mahdi-rstgr/formulation-sdl-atlas/wiki-src/docs/references.md

# References

All 178 references of the review *Self-Driving Laboratories for Formulation: Handling Liquids, Pastes, Powders and Objects, from Robots to Digital Twins and AI Agents* (manuscript V3, in preparation, 2026), numbered as in the manuscript. Citations of the form [n] throughout this wiki link here.

!!! info "Other sources"

    A few pages reconstructed from the earlier version of this wiki also list textbooks, standards and vendor documentation under *Further reading*. Those entries are not part of the review's reference list.

<div class="ref-list" markdown>

<span id="ref-1"></span>**\[1\]** Abolhasani, M.; Kumacheva, E. The rise of self-driving labs in chemical and materials sciences. Nat. Synth. 2023, 2, 483–492. <https://doi.org/10.1038/s44160-022-00231-0>

<span id="ref-2"></span>**\[2\]** Rastegardoost, M. M.; Tafreshi, O. A.; Saadatnia, Z.; Ghaffari-Mosanenzadeh, S.; Park, C. B.; Naguib, H. E. Recent advances on porous materials and structures for high-performance triboelectric nanogenerators. Nano Energy 2023, 111, 108365. <https://doi.org/10.1016/j.nanoen.2023.108365>

<span id="ref-3"></span>**\[3\]** Burger, B.; Maffettone, P. M.; Gusev, V. V.; Aitchison, C. M.; Bai, Y.; Wang, X.; Li, X.; Alston, B. M.; Li, B.; Clowes, R.; Rankin, N.; Harris, B.; Sprick, R. S.; Cooper, A. I. A mobile robotic chemist. Nature 2020, 583, 237–241. <https://doi.org/10.1038/s41586-020-2442-2>

<span id="ref-4"></span>**\[4\]** Szymanski, N. J.; Rendy, B.; Fei, Y.; Kumar, R. E.; He, T.; Milsted, D.; McDermott, M. J.; Gallant, M.; Cubuk, E. D.; Merchant, A.; Kim, H.; Jain, A.; Bartel, C. J.; Persson, K.; Zeng, Y.; Ceder, G. An autonomous laboratory for the accelerated synthesis of inorganic materials. Nature 2023, 624, 86–91. <https://doi.org/10.1038/s41586-023-06734-w>

<span id="ref-5"></span>**\[5\]** King, R. D.; Rowland, J.; Oliver, S. G.; Young, M.; Aubrey, W.; Byrne, E.; Liakata, M.; Markham, M.; Pir, P.; Soldatova, L. N.; Sparkes, A.; Whelan, K. E.; Clare, A. The automation of science. Science 2009, 324 (5923), 85–89. <https://doi.org/10.1126/science.1165620>

<span id="ref-6"></span>**\[6\]** Steiner, S.; Wolf, J.; Glatzel, S.; Andreou, A.; Granda, J. M.; Keenan, G.; Hinkley, T.; Aragon-Camarasa, G.; Kitson, P. J.; Angelone, D.; Cronin, L. Organic synthesis in a modular robotic system driven by a chemical programming language. Science 2019, 363 (6423), eaav2211. <https://doi.org/10.1126/science.aav2211>

<span id="ref-7"></span>**\[7\]** MacLeod, B. P.; Parlane, F. G. L.; Morrissey, T. D.; Häse, F.; Roch, L. M.; Dettelbach, K. E.; Moreira, R.; Yunker, L. P. E.; Rooney, M. B.; Deeth, J. R.; Lai, V.; Ng, G. J.; Situ, H.; Zhang, R. H.; Elliott, M. S.; Haley, T. H.; Dvorak, D. J.; Aspuru-Guzik, A.; Hein, J. E.; Berlinguette, C. P. Self-driving laboratory for accelerated discovery of thin-film materials. Sci. Adv. 2020, 6 (20), eaaz8867. <https://doi.org/10.1126/sciadv.aaz8867>

<span id="ref-8"></span>**\[8\]** Seifrid, M.; Pollice, R.; Aguilar-Granda, A.; Morgan Chan, Z.; Hotta, K.; Ser, C. T.; Vestfrid, J.; Wu, T. C.; Aspuru-Guzik, A. Autonomous chemical experiments: challenges and perspectives on establishing a self-driving lab. Acc. Chem. Res. 2022, 55 (17), 2454–2466. <https://doi.org/10.1021/acs.accounts.2c00220>

<span id="ref-9"></span>**\[9\]** Stach, E.; DeCost, B.; Kusne, A. G.; Hattrick-Simpers, J.; Brown, K. A.; Reyes, K. G.; Schrier, J.; Billinge, S.; Buonassisi, T.; Foster, I.; Gomes, C. P.; Gregoire, J. M.; Mehta, A.; Montoya, J.; Olivetti, E.; Park, C.; Rotenberg, E.; Saikin, S. K.; Smullin, S.; Stanev, V.; Maruyama, B. Autonomous experimentation systems for materials development: a community perspective. Matter 2021, 4 (9), 2702–2726. <https://doi.org/10.1016/j.matt.2021.06.036>

<span id="ref-10"></span>**\[10\]** Tom, G.; Schmid, S. P.; Baird, S. G.; Cao, Y.; Darvish, K.; Hao, H.; Lo, S.; Pablo-García, S.; Rajaonson, E. M.; Skreta, M.; Yoshikawa, N.; Corapi, S.; Akkoc, G. D.; Strieth-Kalthoff, F.; Seifrid, M.; Aspuru-Guzik, A. Self-driving laboratories for chemistry and materials science. Chem. Rev. 2024, 124 (16), 9633–9732. <https://doi.org/10.1021/acs.chemrev.4c00055>

<span id="ref-11"></span>**\[11\]** Velasco, P. Q.; Low, K. Y. A.; Leong, C. J.; Ng, W. T.; Qiu, S.; Jhunjhunwala, S.; Li, B.; Qian, A.; Hippalgaonkar, K.; Cheng, J. J. W. Optimization of liquid handling parameters for viscous liquid transfers with pipetting robots, a "sticky situation." Digital Discovery 2024, 3 (5), 1011–1020. <https://doi.org/10.1039/D3DD00255A>

<span id="ref-12"></span>**\[12\]** Radulov, N.; Little, T.; Cooper, A. I.; Pizzuto, G. Vision-guided adaptive scooping for powder weighing in autonomous chemistry laboratories. Digital Discovery 2026, 5 (5), 2120–2127. <https://doi.org/10.1039/D5DD00569H>

<span id="ref-13"></span>**\[13\]** Tadros, T. F. Rheology of Dispersions: Principles and Applications; Wiley-VCH: Weinheim, 2010. ISBN 978-3-527-32003-5.

<span id="ref-14"></span>**\[14\]** Mezger, T. G. The Rheology Handbook: For Users of Rotational and Oscillatory Rheometers, 5th ed.; Vincentz Network: Hannover, 2020. ISBN 978-3-86630-532-8.

<span id="ref-15"></span>**\[15\]** Opentrons Labworks Inc. OT-2 and Flex Liquid Handling Robots; product pages. <https://opentrons.com/products/ot-2-robot> (accessed 2026).

<span id="ref-16"></span>**\[16\]** Hamilton Company. Microlab STAR Automated Liquid Handling Workstation; product page. <https://www.hamiltoncompany.com> (accessed 2026).

<span id="ref-17"></span>**\[17\]** Nordson EFD. Ultimus V Precision Dispenser; product page. <https://www.nordson.com/en/products/efd-products/ultimus-v-dispensers> (accessed 2026).

<span id="ref-18"></span>**\[18\]** Bahr, M. N.; Damon, D.; Yates, S.; Chin, A.; Christopher, D.; Cromer, S.; Perrotto, N.; Quiroz, J.; Rosso, V. Collaborative Evaluation of Commercially Available Automated Powder Dispensing Platforms for High-Throughput Experimentation in Pharmaceutical Applications. Org. Process Res. Dev. 2018, 22 (11), 1500–1508. <https://doi.org/10.1021/acs.oprd.8b00259>

<span id="ref-19"></span>**\[19\]** Barnes, H. A. A Handbook of Elementary Rheology; University of Wales Institute of Non-Newtonian Fluid Mechanics: Aberystwyth, 2000 (reprinted 2005). ISBN 0-9538032-0-1.

<span id="ref-20"></span>**\[20\]** Macosko, C. W. Rheology: Principles, Measurements, and Applications; VCH Publishers: New York, 1994. ISBN 1-56081-579-5.

<span id="ref-21"></span>**\[21\]** Kanase, D.; Watson, T. Viscous Liquid Handling Automation Using the Opentrons OT-2; Application Note; Opentrons Labworks Inc. <https://opentrons-landing-img.s3.amazonaws.com/application+notes/Viscous+Liquids+App+Note.pdf> (accessed 2026).

<span id="ref-22"></span>**\[22\]** Deshmukh, S.; Bishop, M. T.; Dermody, D.; Dietsche, L.; Kuo, T.-C.; Mushrush, M.; Harris, K.; Zieman, J.; Morabito, P.; Orvosh, B.; Patrick, D. A Novel High-Throughput Viscometer. ACS Comb. Sci. 2016, 18 (7), 405–414. <https://doi.org/10.1021/acscombsci.5b00176>

<span id="ref-23"></span>**\[23\]** Soh, B. W.; Chitre, A.; Tan, S. Z.; Wang, Y.; Yi, Y.; Soh, W.; Hippalgaonkar, K.; Wilson, D. I. Opentrons for automated and high-throughput viscometry. Digital Discovery 2025, 4 (3), 711–722. <https://doi.org/10.1039/D4DD00368C>

<span id="ref-24"></span>**\[24\]** Zhang, H.; Jin, J.; Zhao, Z.; He, Z.; Zhou, Y.; Duan, X. Self-focused acoustically driven pL-level dispensing pipet enabling rapid concentration gradient generation. Anal. Chem. 2025, 97 (47), 26274–26282. <https://doi.org/10.1021/acs.analchem.5c05838>

<span id="ref-25"></span>**\[25\]** Durrer, J.; Agrawal, P.; Ozgul, A.; Neuhauss, S. C. F.; Nama, N.; Ahmed, D. A robot-assisted acoustofluidic end effector. Nat. Commun. 2022, 13, 6370. <https://doi.org/10.1038/s41467-022-34167-y>

<span id="ref-26"></span>**\[26\]** Ozgulbas, D. Y. et al. Robotic pendant drop: containerless liquid for μs-resolved, AI-executable XPCS. Light Sci. Appl. 2023, 12, 196. <https://doi.org/10.1038/s41377-023-01233-z>

<span id="ref-27"></span>**\[27\]** Xu, S.; Nunez, C. M.; Souri, M.; Wood, R. J. A compact DEA-based soft peristaltic pump for power and control of fluidic robots. Sci. Robot. 2023, 8 (79), eadd4649. <https://doi.org/10.1126/scirobotics.add4649>

<span id="ref-28"></span>**\[28\]** Walker, M.; Pizzuto, G.; Fakhruldeen, H.; Cooper, A. I. Go with the flow: deep learning methods for autonomous viscosity estimations. Digital Discovery 2023, 2 (5), 1540–1547. <https://doi.org/10.1039/D3DD00109A>

<span id="ref-29"></span>**\[29\]** Rastegardoost, M. M.; Tafreshi, O. A.; Saadatnia, Z.; Ghaffari-Mosanenzadeh, S.; Park, C. B.; Naguib, H. E. Porous PVDF mats with significantly enhanced dielectric properties and novel dipole arrangement for high-performance triboelectric nanogenerators. Appl. Mater. Today 2023, 30, 101732. <https://doi.org/10.1016/j.apmt.2023.101732>

<span id="ref-30"></span>**\[30\]** Malkin, A. Ya.; Derkach, S. R.; Kulichikhin, V. G. Rheology of Gels and Yielding Liquids. Gels 2023, 9 (9), 715. <https://doi.org/10.3390/gels9090715>

<span id="ref-31"></span>**\[31\]** Luo, X.; Jin, S.; Huang, H.-J.; Yuan, W. An Intelligent Robotic System for Perceptive Pancake Batter Stirring and Precise Pouring. In 2024 IEEE/RSJ International Conference on Intelligent Robots and Systems (IROS); IEEE, 2024. arXiv:2407.01755.

<span id="ref-32"></span>**\[32\]** Yang, X.; Ji, Z.; Lai, Y.-K. Differentiable physics-based system identification for robotic manipulation of elastoplastic materials. Int. J. Robot. Res. 2025, 44 (13), 2126–2155. <https://doi.org/10.1177/02783649251334661>

<span id="ref-33"></span>**\[33\]** Kelly, D.; Sergis, V.; Ventura i Blanco, L.; Mason, K.; Daly, A. C. Autonomous control of extrusion bioprinting using convolutional neural networks. Adv. Funct. Mater. 2025, 35, 2424553. <https://doi.org/10.1002/adfm.202424553>

<span id="ref-34"></span>**\[34\]** Shin, J.; Kang, R.; Hyun, K.; Li, Z.; Kumar, H.; Kim, K.; Park, S. S.; Kim, K. Machine learning-enhanced optimization for high-throughput precision in cellular droplet bioprinting. Adv. Sci. 2025, 12 (20), e2412831. <https://doi.org/10.1002/advs.202412831>

<span id="ref-35"></span>**\[35\]** Rastegardoost, M. M.; Tafreshi, O. A.; Saadatnia, Z.; Ghaffari-Mosanenzadeh, S.; Serles, P.; Filleter, T.; Park, C. B.; Naguib, H. E. Highly durable triboelectric nanogenerators based on fibrous fluoropolymer composite mats with enhanced mechanical and dielectric properties. Mater. Today Energy 2023, 38, 101431. <https://doi.org/10.1016/j.mtener.2023.101431>

<span id="ref-36"></span>**\[36\]** Abbas, F.; Salehian, M.; Hou, P. et al. Accelerated drug development using a digital formulator and a self-driving tableting data factory. Nat. Commun. 2026, 17, 4739. <https://doi.org/10.1038/s41467-026-71204-6>

<span id="ref-37"></span>**\[37\]** Fermier, A. M.; Troisi, J.; Heritage, E. C.; Drexel, M. A.; Gallea, P.; Swinney, K. A. Powder dispensing robot for sample preparation. Analyst 2003, 128, 790–795. <https://doi.org/10.1039/b300274h>

<span id="ref-38"></span>**\[38\]** Kadokawa, Y.; Hamaya, M.; Tanaka, K. Learning robotic powder weighing from simulation for laboratory automation. In 2023 IEEE/RSJ International Conference on Intelligent Robots and Systems (IROS); IEEE: Detroit, MI, 2023; pp. 2932–2939.

<span id="ref-39"></span>**\[39\]** Radulov, N.; Wright, A.; Little, T.; Cooper, A. I.; Pizzuto, G. FLIP: Flowability-Informed Powder Weighing. arXiv:2506.03896, 2025.

<span id="ref-40"></span>**\[40\]** Takahashi, T.; Nakajima, Y.; Beltran-Hernandez, C. C.; Kuroda, Y.; Tanaka, K.; Hamaya, M.; Ono, K.; Ushiku, Y. A Flexible Funnel-Shaped Robotic Hand with an Integrated Single-Sheet Valve for Milligram-Scale Powder Handling. arXiv:2512.07091, 2025.

<span id="ref-41"></span>**\[41\]** Wei, M.; Yang, X.; Lai, Y.-K.; Tafrishi, S. A.; Ji, Z. A physics-informed demonstration-guided learning framework for granular material manipulation. IEEE Trans. Neural Netw. Learn. Syst. 2026, 37 (4), 1590–1604. <https://doi.org/10.1109/TNNLS.2025.3622482>

<span id="ref-42"></span>**\[42\]** Szymańska, E.; Hughes, J. Robotic optimization of powdered beverages leveraging computer vision and Bayesian optimization. Front. Robot. AI 2025, 12, 1603729. <https://doi.org/10.3389/frobt.2025.1603729>

<span id="ref-43"></span>**\[43\]** Xu, J.; Jia, Y.; Yang, D.; Meng, P.; Zhu, X.; Guo, Z.; Song, S.; Ciocarlie, M. Tactile-based object retrieval from granular media. Auton. Robots 2025, 49 (4), 32. <https://doi.org/10.1007/s10514-025-10212-9>

<span id="ref-44"></span>**\[44\]** Treers, L.; Soto, D.; Hwang, J.; Goodisman, M. A. D.; Goldman, D. I. Robot excavation and manipulation of geometrically cohesive granular media. Granular Matter 2026, 28 (2), 35. <https://doi.org/10.1007/s10035-025-01597-6>

<span id="ref-45"></span>**\[45\]** Lo, S.; Baird, S. G.; Schrier, J.; Blaiszik, B.; Carson, N.; Foster, I.; Aguilar-Granda, A.; Kalinin, S. V.; Maruyama, B.; Politi, M.; Tran, H.; Sparks, T. D.; Aspuru-Guzik, A. Review of low-cost self-driving laboratories in chemistry and materials science: the “frugal twin” concept. Digital Discovery 2024, 3 (5), 842–868. <https://doi.org/10.1039/D3DD00223C>

<span id="ref-46"></span>**\[46\]** SainSmart. Genmitsu 4040-PRO Desktop CNC Machine; product page, <https://www.sainsmart.com/collections/cnc-machines/products/genmitsu-4040-pro-semi-assembly-desktop-cnc-machine-for-carving-and-cutting>; running accuracy from the 4040-PRO MAX product page, <https://www.sainsmart.com/products/4040-pro-max> (accessed 2026).

<span id="ref-47"></span>**\[47\]** igus GmbH. drylin XYZ Gantry Robot; product configurator page. <https://www.igus.com/automation/xyz-gantry> (accessed 2026).

<span id="ref-48"></span>**\[48\]** Machine Agency, University of Washington. Jubilee: An Open-Source Multi-Tool Motion Platform; specifications, <https://jubilee3d.com/index.php?title=Specs>; and Science Jubilee Pipette Tool documentation, <https://science-jubilee.readthedocs.io/en/latest/building/pipette_tool.html> (accessed 2026).

<span id="ref-49"></span>**\[49\]** Brooks Automation (Precise Automation). PreciseFlex 400; datasheet 379272-en-US. <https://www.brooks.com> (accessed 2026).

<span id="ref-50"></span>**\[50\]** Seiko Epson Corporation. RS3 SCARA Robot (RRS-351SSR13); product page. <https://www.epson.com> (accessed 2026).

<span id="ref-51"></span>**\[51\]** Universal Robots A/S. UR3e Collaborative Robot Arm; product page and e-Series datasheet. <https://www.universal-robots.com/products/ur3e/> (accessed 2026).

<span id="ref-52"></span>**\[52\]** UFACTORY. xArm 6 Collaborative Robot; product page. <https://www.ufactory.us/product/ufactory-xarm-6> (accessed 2026).

<span id="ref-53"></span>**\[53\]** UFACTORY. Lite 6 Collaborative Robot Arm; product listing (Knox Labs). <https://www.knoxlabs.com/products/ufactory-lite-6-collaborative-robot-arm> (accessed 2026).

<span id="ref-54"></span>**\[54\]** Franka Robotics GmbH. Franka Research 3; datasheet R02212, Rev. 2.4. <https://franka.de/hubfs/Datasheet_FrankaResearch3_R02212_2.4.pdf?hsLang=en> (accessed 2026).

<span id="ref-55"></span>**\[55\]** Kinova Inc. Gen3 Ultra Lightweight Robot; one-pager specification. <https://www.kinovarobotics.com/uploads/Kinova_Onepager_Gen3_2024_EN.pdf> (accessed 2026).

<span id="ref-56"></span>**\[56\]** Lunt, A. M.; Fakhruldeen, H.; Pizzuto, G. et al. Modular, multi-robot integration of laboratories: an autonomous workflow for solid-state chemistry. Chem. Sci. 2024, 15 (7), 2456–2463. <https://doi.org/10.1039/D3SC06206F>

<span id="ref-57"></span>**\[57\]** Dai, T.; Vijayakrishnan, S.; Szczypiński, F. T.; Ayme, J.-F.; Simaei, E.; Fellowes, T.; Clowes, R.; Kotopanov, L.; Shields, C. E.; Zhou, Z.; Ward, J. W.; Cooper, A. I. Autonomous mobile robots for exploratory synthetic chemistry. Nature 2024, 635, 890–897. <https://doi.org/10.1038/s41586-024-08173-7>

<span id="ref-58"></span>**\[58\]** KUKA AG. KMR iiwa Mobile Robot System; product brochure, <https://www.parmley-graham.co.uk/content/wp-content/uploads/2024/07/KUKA_KMRiiwa_EN.pdf>; platform positioning, <https://qviro.com/product/kuka/kmr-iiwa>; reseller price listing, <https://www.indiamart.com/proddetail/kuka-kmr-iiwa-2854399368830.html> (accessed 2026).

<span id="ref-59"></span>**\[59\]** Rainin (Mettler-Toledo). E4 XLS+ Electronic Pipette; product specification. <https://www.shoprainin.com/Products/Pipettes-and-Tips/Pipettes/Single-Channel-Electronic-Pipettes/E4-XLS/E4-Electronic-Pipette,-LTS-E4-1000XLS+/p/17014482> (accessed 2026).

<span id="ref-60"></span>**\[60\]** Eppendorf SE. Xplorer / Xplorer plus Electronic Pipettes; product page. <https://www.eppendorf.com/us-en/Products/Liquid-Handling/All-Pipettes-Dispensers-Automated-Liquid-Handlers/Eppendorf-Xplorer-Eppendorf-Xplorer-plus-p-PF-191054> (accessed 2026).

<span id="ref-61"></span>**\[61\]** Gilson, Inc. MICROMAN E Positive-Displacement Pipette; User’s Guide LT801547-E. <https://es.gilson.com/pub/media/docs/LT801547-E_MICROMAN_E_UG_web.pdf> (accessed 2026).

<span id="ref-62"></span>**\[62\]** Hamilton Company. PSD/4 Syringe Pump; specification sheet. <https://www.hamiltoncompany.com/knowledge-base/spec-sheet/psd-4-specification-sheet> (accessed 2026).

<span id="ref-63"></span>**\[63\]** Watson-Marlow Fluid Technology Solutions. Qdos 20 Chemical Metering Pump; product page. <https://www.wmfts.com/en-us/brands/watson-marlow-peristaltic-pumps/cased-pumps/qdos-accurate-versatile-chemical-dosing-pumps/> (accessed 2026).

<span id="ref-64"></span>**\[64\]** Cole-Parmer (Avantor). Masterflex L/S Digital Precision Pump System; product listing. <https://www.fishersci.com/shop/products/masterflex-l-s-digital-precision-pump-systems-open-head-sensor-easy-load-head-4/11747346> (accessed 2026).

<span id="ref-65"></span>**\[65\]** CELLINK (BICO Group). Syringe Pump Printhead; product page. <https://www.cellink.com/product/syringe-pump-printhead/> (accessed 2026).

<span id="ref-66"></span>**\[66\]** Allevi (3D Systems). Allevi 2 Bioprinter; product page. <https://www.allevi3d.com/allevi-2/> (accessed 2026).

<span id="ref-67"></span>**\[67\]** CELLINK (BICO Group). BIO X Pneumatic Printhead; product page. <https://www.cellink.com/product/bio-x-pneumatic-printhead/> (accessed 2026).

<span id="ref-68"></span>**\[68\]** ViscoTec Pumpen- u. Dosiertechnik GmbH. preeflow eco-PEN Precision Volumetric Dosing Pump; product page. <https://www.preeflow.com/en/hoechste-praezision-als-standard/> (accessed 2026).

<span id="ref-69"></span>**\[69\]** Fisnar Inc. PDV-1000 Precision Positive-Displacement Auger Valve; product page. <https://www.fisnar.com/products/dispensing-valves/positive-displacement-dispensing-valves/pdv1000-precision-positive-displacement-auger-valves/> (accessed 2026).

<span id="ref-70"></span>**\[70\]** Coperion K-Tron. Micro-Screw Feeders (MT12); product page. <https://coperion.com/en/products-services/process-equipment/feeders/micro-screw-feeders> (accessed 2026).

<span id="ref-71"></span>**\[71\]** Chemspeed Technologies AG. SWILE Gravimetric Powder Dosing; product page. <https://www.chemspeed.com/crystal-swile/> (accessed 2026).

<span id="ref-72"></span>**\[72\]** Mettler-Toledo International. Quantos Automated Powder and Liquid Dosing; data sheet. <https://www.mt.com/us/en/home/library/product-brochures/laboratory-weighing/06_Automated_Sample_Preparation/02_QB_Liquid_Powder_Dispensing/02_Data_Sheets/DS_QB_Powde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> (accessed 2026).

<span id="ref-73"></span>**\[73\]** 3P Innovation Ltd. VF1 Vibratory Feeder; product page. <https://www.3pinnovation.com/pharma-equipment/discover-range/vibratory-feeder> (accessed 2026).

<span id="ref-74"></span>**\[74\]** Eriez Manufacturing Co. Hi-Vi Volumatic Feeder Machine; product page. <https://www.eriez.com/Products/Sample-Preparation/Vibratory-Feeders/Volumatic-Feeder-Machine> (accessed 2026).

<span id="ref-75"></span>**\[75\]** Eppendorf SE. epMotion 5075 Automated Pipetting Workstation; technical specifications brochure. <https://www.eppendorf.com> (accessed 2026).

<span id="ref-76"></span>**\[76\]** Dispendix GmbH. I.DOT Non-Contact Liquid Handler; product page. <https://www.dispendix.com/idot-non-contact-liquid-handler> (accessed 2026).

<span id="ref-77"></span>**\[77\]** Tecan Group Ltd. Fluent Laboratory Automation Workstation; product page. <https://lifesciences.tecan.com/fluent-laboratory-automation-workstation> (accessed 2026).

<span id="ref-78"></span>**\[78\]** Beckman Coulter Life Sciences. Biomek i7 Automated Workstation; product page. <https://www.beckman.com/liquid-handlers/biomek-i-series-automated-workstations/biomek-i7> (accessed 2026).

<span id="ref-79"></span>**\[79\]** Agilent Technologies. Bravo Automated Liquid Handling Platform; product page. <https://www.agilent.com/en/product/automated-liquid-handling/automated-liquid-handling-platforms/bravo-automated-liquid-handling-platform> (accessed 2026).

<span id="ref-80"></span>**\[80\]** Beckman Coulter Life Sciences. Echo 525 Acoustic Liquid Handler; product page. <https://www.beckman.com/liquid-handlers/echo-acoustic/echo-525> (accessed 2026).

<span id="ref-81"></span>**\[81\]** Soh, B. W.; Chitre, A.; Lee, W. Y.; Bash, D.; Kumar, J. N.; Hippalgaonkar, K. Automated pipetting robot for proxy high-throughput viscometry of Newtonian fluids. Digital Discovery 2023, 2 (2), 481–488. <https://doi.org/10.1039/D2DD00126H>

<span id="ref-82"></span>**\[82\]** Councill, E. E. A. W.; Axtell, N. B.; Truong, T.; Liang, Y.; Aposhian, A. L.; Webber, K. G. I.; Zhu, Y.; Cong, Y.; Carson, R. H.; Kelly, R. T. Adapting a low-cost and open-source commercial pipetting robot for nanoliter liquid handling. SLAS Technol. 2021, 26 (3), 310–319. <https://doi.org/10.1177/2472630320973591>

<span id="ref-83"></span>**\[83\]** Axtell, N. B.; Webber, K. G. I. et al. Modification of a low-cost pipetting robot for nanoliter liquid handling and autosampling for liquid chromatography-mass spectrometry. J. Sep. Sci. 2026, 49 (2), e70379. <https://doi.org/10.1002/jssc.70379>

<span id="ref-84"></span>**\[84\]** Yoshikawa, N.; Darvish, K.; Ghazi Vakili, M.; Garg, A.; Aspuru-Guzik, A. Digital pipette: open hardware for liquid transfer in self-driving laboratories. Digital Discovery 2023, 2 (6), 1745–1751. <https://doi.org/10.1039/D3DD00115F>

<span id="ref-85"></span>**\[85\]** Zwirnmann, H.; Knobbe, D.; Culha, U.; Haddadin, S. Towards flexible biolaboratory automation: container taxonomy-based, 3D-printed gripper fingers. In 2023 IEEE/RSJ International Conference on Intelligent Robots and Systems (IROS); IEEE: Detroit, MI, 2023. arXiv:2302.03644.

<span id="ref-86"></span>**\[86\]** Nazeri, M.; Watchorn, J.; Mei, S.; Zhang, A.; Allen, C.; Gu, F. Leveraging flexible pipette-based tool changes to transform liquid handling systems into dual-function sample preparation and imaging platforms. HardwareX 2025, 22, e00653. <https://doi.org/10.1016/j.ohx.2025.e00653>

<span id="ref-87"></span>**\[87\]** del Olmo Lianes, I.; Yubero, P.; Gómez-Luengo, Á.; Nogales, J.; Espeso, D. R. Technical upgrade of an open-source liquid handler to support bacterial colony screening. Front. Bioeng. Biotechnol. 2023, 11, 1202836. <https://doi.org/10.3389/fbioe.2023.1202836>

<span id="ref-88"></span>**\[88\]** Wierenga, R. P.; Golas, S. M.; Ho, W.; Coley, C. W.; Esvelt, K. M. PyLabRobot: an open-source, hardware-agnostic interface for liquid-handling robots and accessories. Device 2023, 1 (4), 100111. <https://doi.org/10.1016/j.device.2023.100111>

<span id="ref-89"></span>**\[89\]** Grieves, M.; Vickers, J. Digital twin: mitigating unpredictable, undesirable emergent behavior in complex systems. In Transdisciplinary Perspectives on Complex Systems; Kahlen, F.-J., Flumerfelt, S., Alves, A., Eds.; Springer: Cham, 2017; pp 85–113. <https://doi.org/10.1007/978-3-319-38756-7_4>

<span id="ref-90"></span>**\[90\]** Tao, F.; Zhang, H.; Liu, A.; Nee, A. Y. C. Digital twin in industry: state-of-the-art. IEEE Trans. Ind. Inform. 2019, 15 (4), 2405–2415. <https://doi.org/10.1109/TII.2018.2873186>

<span id="ref-91"></span>**\[91\]** Pal, P. K.; Hens, A.; Behera, N.; Lahiri, S. K. Digital twins: transforming the chemical process industry—a review. Can. J. Chem. Eng. 2025, 103 (8), 3611–3636. <https://doi.org/10.1002/cjce.25611>

<span id="ref-92"></span>**\[92\]** Zhang, S.; Zhang, J.; Lapkin, A. A. A knowledge graph framework for digital twins of chemical processes. Nat. Chem. Eng. 2026, 3 (5), 286–297. <https://doi.org/10.1038/s44286-026-00392-1>

<span id="ref-93"></span>**\[93\]** Rihm, S. D.; Bai, J.; Kondinski, A.; Mosbach, S.; Akroyd, J.; Kraft, M. Transforming research laboratories with connected digital twins. Nexus 2024, 1 (1), 100004. <https://doi.org/10.1016/j.ynexs.2024.100004>

<span id="ref-94"></span>**\[94\]** SimPy. SimPy: discrete event simulation for Python; software documentation. <https://simpy.readthedocs.io> (accessed 2026).

<span id="ref-95"></span>**\[95\]** Bär, H.; Hochstrasser, R.; Papenfuß, B. SiLA: basic standards for rapid integration in laboratory automation. J. Lab. Autom. 2012, 17 (2), 86–95. <https://doi.org/10.1177/2211068211424550>

<span id="ref-96"></span>**\[96\]** Macenski, S.; Foote, T.; Gerkey, B.; Lalancette, C.; Woodall, W. Robot Operating System 2: design, architecture, and uses in the wild. Sci. Robot. 2022, 7 (66), eabm6074. <https://doi.org/10.1126/scirobotics.abm6074>

<span id="ref-97"></span>**\[97\]** Coleman, D.; Şucan, I. A.; Chitta, S.; Correll, N. Reducing the barrier to entry of complex robotic software: a MoveIt! case study. J. Softw. Eng. Robot. 2014, 5 (1), 3–16. arXiv:1404.3785.

<span id="ref-98"></span>**\[98\]** Beeson, P.; Ames, B. TRAC-IK: an open-source library for improved solving of generic inverse kinematics. In 2015 IEEE-RAS 15th International Conference on Humanoid Robots (Humanoids); IEEE: Seoul, South Korea, 2015; pp 928–935. <https://doi.org/10.1109/HUMANOIDS.2015.7363472>

<span id="ref-99"></span>**\[99\]** Şucan, I. A.; Moll, M.; Kavraki, L. E. The Open Motion Planning Library. IEEE Robot. Autom. Mag. 2012, 19 (4), 72–82. <https://doi.org/10.1109/MRA.2012.2205651>

<span id="ref-100"></span>**\[100\]** Pan, J.; Chitta, S.; Manocha, D. FCL: a general purpose library for collision and proximity queries. In 2012 IEEE International Conference on Robotics and Automation (ICRA); IEEE: Saint Paul, MN, USA, 2012; pp 3859–3866. <https://doi.org/10.1109/ICRA.2012.6225337>

<span id="ref-101"></span>**\[101\]** Fakhruldeen, H.; Pizzuto, G.; Glowacki, J.; Cooper, A. I. ARChemist: autonomous robotic chemistry system architecture. In 2022 International Conference on Robotics and Automation (ICRA); IEEE: Philadelphia, PA, USA, 2022; pp 6013–6019. <https://doi.org/10.1109/ICRA46639.2022.9811996>

<span id="ref-102"></span>**\[102\]** Koenig, N.; Howard, A. Design and use paradigms for Gazebo, an open-source multi-robot simulator. In 2004 IEEE/RSJ International Conference on Intelligent Robots and Systems (IROS); IEEE: Sendai, Japan, 2004; Vol. 3, pp 2149–2154. <https://doi.org/10.1109/IROS.2004.1389727>

<span id="ref-103"></span>**\[103\]** Todorov, E.; Erez, T.; Tassa, Y. MuJoCo: a physics engine for model-based control. In 2012 IEEE/RSJ International Conference on Intelligent Robots and Systems (IROS); IEEE: Vilamoura-Algarve, Portugal, 2012; pp 5026–5033. <https://doi.org/10.1109/IROS.2012.6386109>

<span id="ref-104"></span>**\[104\]** Coumans, E.; Bai, Y. PyBullet, a Python module for physics simulation for games, robotics and machine learning; software, 2016–2021. <https://pybullet.org> (accessed 2026).

<span id="ref-105"></span>**\[105\]** Rohmer, E.; Singh, S. P. N.; Freese, M. V-REP: a versatile and scalable robot simulation framework. In 2013 IEEE/RSJ International Conference on Intelligent Robots and Systems (IROS); IEEE: Tokyo, Japan, 2013; pp 1321–1326. <https://doi.org/10.1109/IROS.2013.6696520>

<span id="ref-106"></span>**\[106\]** Michel, O. Cyberbotics Ltd. Webots™: professional mobile robot simulation. Int. J. Adv. Robot. Syst. 2004, 1 (1), 5. <https://doi.org/10.5772/5618>

<span id="ref-107"></span>**\[107\]** Makoviychuk, V.; Wawrzyniak, L.; Guo, Y. et al. Isaac Gym: high performance GPU-based physics simulation for robot learning. In Proceedings of the Neural Information Processing Systems Track on Datasets and Benchmarks 1 (NeurIPS Datasets and Benchmarks 2021); 2021; arXiv:2108.10470.

<span id="ref-108"></span>**\[108\]** Mittal, M.; Yu, C.; Yu, Q. et al. Orbit: a unified simulation framework for interactive robot learning environments. IEEE Robot. Autom. Lett. 2023, 8 (6), 3740–3747. <https://doi.org/10.1109/LRA.2023.3270034>

<span id="ref-109"></span>**\[109\]** Mittal, M.; Roth, P.; Tigue, J. et al. Isaac Lab: a GPU-accelerated simulation framework for multi-modal robot learning. arXiv 2025, arXiv:2511.04831.

<span id="ref-110"></span>**\[110\]** Li, S.; Huang, Y.; Guo, C.; Wu, T.; Zhang, J.; Zhang, L.; Ding, W. Chemistry3D: robotic interaction toolkit for chemistry experiments. In 2025 IEEE International Conference on Robotics and Automation (ICRA); IEEE: Atlanta, GA, USA, 2025; pp 8064–8071. <https://doi.org/10.1109/ICRA55743.2025.11128846>

<span id="ref-111"></span>**\[111\]** Darvish, K.; Sohal, A.; Mandal, A. et al. MATTERIX: toward a digital twin for robotics-assisted chemistry laboratory automation. Nat. Comput. Sci. 2026, 6 (1), 67–82. <https://doi.org/10.1038/s43588-025-00924-4>

<span id="ref-112"></span>**\[112\]** Hirt, C. W.; Nichols, B. D. Volume of fluid (VOF) method for the dynamics of free boundaries. J. Comput. Phys. 1981, 39 (1), 201–225. <https://doi.org/10.1016/0021-9991(81)90145-5>

<span id="ref-113"></span>**\[113\]** Monaghan, J. J. Smoothed particle hydrodynamics. Annu. Rev. Astron. Astrophys. 1992, 30, 543–574. <https://doi.org/10.1146/annurev.aa.30.090192.002551>

<span id="ref-114"></span>**\[114\]** Macklin, M.; Müller, M.; Chentanez, N.; Kim, T.-Y. Unified particle physics for real-time applications. ACM Trans. Graph. 2014, 33 (4). <https://doi.org/10.1145/2601097.2601152>

<span id="ref-115"></span>**\[115\]** Schenck, C.; Fox, D. SPNets: differentiable fluid dynamics for deep neural networks. In Proceedings of The 2nd Conference on Robot Learning (CoRL 2018), PMLR vol. 87; 2018; pp 317–335.

<span id="ref-116"></span>**\[116\]** Sulsky, D.; Chen, Z.; Schreyer, H. L. A particle method for history-dependent materials. Comput. Methods Appl. Mech. Eng. 1994, 118 (1–2), 179–196. <https://doi.org/10.1016/0045-7825(94)90112-0>

<span id="ref-117"></span>**\[117\]** Stomakhin, A.; Schroeder, C.; Chai, L.; Teran, J.; Selle, A. A material point method for snow simulation. ACM Trans. Graph. 2013, 32 (4), 102. <https://doi.org/10.1145/2461912.2461948>

<span id="ref-118"></span>**\[118\]** Huang, Z.; Hu, Y.; Du, T.; Zhou, S.; Su, H.; Tenenbaum, J. B.; Gan, C. PlasticineLab: a soft-body manipulation benchmark with differentiable physics. In International Conference on Learning Representations (ICLR 2021); 2021; arXiv:2104.03311.

<span id="ref-119"></span>**\[119\]** Hu, Y.; Anderson, L.; Li, T.-M.; Sun, Q.; Carr, N.; Ragan-Kelley, J.; Durand, F. DiffTaichi: differentiable programming for physical simulation. In International Conference on Learning Representations (ICLR 2020); 2020; arXiv:1910.00935.

<span id="ref-120"></span>**\[120\]** Xian, Z.; Zhu, B.; Xu, Z.; Tung, H.-Y.; Torralba, A.; Fragkiadaki, K.; Gan, C. FluidLab: a differentiable environment for benchmarking complex fluid manipulation. In International Conference on Learning Representations (ICLR 2023); 2023; arXiv:2303.02346.

<span id="ref-121"></span>**\[121\]** Cundall, P. A.; Strack, O. D. L. A discrete numerical model for granular assemblies. Géotechnique 1979, 29 (1), 47–65. <https://doi.org/10.1680/geot.1979.29.1.47>

<span id="ref-122"></span>**\[122\]** Coetzee, C. J. Review: calibration of the discrete element method. Powder Technol. 2017, 310, 104–142. <https://doi.org/10.1016/j.powtec.2017.01.015>

<span id="ref-123"></span>**\[123\]** Jop, P.; Forterre, Y.; Pouliquen, O. A constitutive law for dense granular flows. Nature 2006, 441 (7094), 727–730. <https://doi.org/10.1038/nature04801>

<span id="ref-124"></span>**\[124\]** Tobin, J.; Fong, R.; Ray, A.; Schneider, J.; Zaremba, W.; Abbeel, P. Domain randomization for transferring deep neural networks from simulation to the real world. In 2017 IEEE/RSJ International Conference on Intelligent Robots and Systems (IROS); IEEE: Vancouver, BC, Canada, 2017; pp 23–30. <https://doi.org/10.1109/IROS.2017.8202133>

<span id="ref-125"></span>**\[125\]** Boiko, D. A.; MacKnight, R.; Kline, B.; Gomes, G. Autonomous chemical research with large language models. Nature 2023, 624, 570–578. <https://doi.org/10.1038/s41586-023-06792-0>

<span id="ref-126"></span>**\[126\]** Yoshikawa, N.; Skreta, M.; Darvish, K. et al. Large language models for chemistry robotics. Auton. Robots 2023, 47 (8), 1057–1086. <https://doi.org/10.1007/s10514-023-10136-2>

<span id="ref-127"></span>**\[127\]** M. Bran, A.; Cox, S.; Schilter, O.; Baldassari, C.; White, A. D.; Schwaller, P. Augmenting large language models with chemistry tools. Nat. Mach. Intell. 2024, 6 (5), 525–535. <https://doi.org/10.1038/s42256-024-00832-8>

<span id="ref-128"></span>**\[128\]** Zhao, W.; Queralta, J. P.; Westerlund, T. Sim-to-real transfer in deep reinforcement learning for robotics: a survey. In 2020 IEEE Symposium Series on Computational Intelligence (SSCI); IEEE: Canberra, ACT, Australia, 2020; pp 737–744. <https://doi.org/10.1109/SSCI47803.2020.9308468>

<span id="ref-129"></span>**\[129\]** Mandal, I.; Soni, J.; Zaki, M. et al. Evaluating large language model agents for automation of atomic force microscopy. Nat. Commun. 2025, 16, 9104. <https://doi.org/10.1038/s41467-025-64105-7>

<span id="ref-130"></span>**\[130\]** Tang, X.; Jin, Q.; Zhu, K. et al. Risks of AI scientists: prioritizing safeguarding over autonomy. Nat. Commun. 2025, 16, 8317. <https://doi.org/10.1038/s41467-025-63913-1>

<span id="ref-131"></span>**\[131\]** Rastegardoost, M. M.; Tafreshi, O. A.; Ghaffari-Mosanenzadeh, S.; Park, C. B.; Naguib, H. E. Ultra-lightweight aerogel-fibrous material with high thermal stability and boosted triboelectricity for crack detection in harsh environments. Mater. Today Energy 2026, 56, 102221. <https://doi.org/10.1016/j.mtener.2026.102221>

<span id="ref-132"></span>**\[132\]** Rastegardoost, M. M.; Aghababaei Tafreshi, O.; Ghaffari-Mosanenzadeh, S.; Saadatnia, Z.; Park, C. B.; Naguib, H. E. Ultra-lightweight aerogel composites for sound-driven triboelectric nanogenerator. Nano Energy 2025, 136, 110765. <https://doi.org/10.1016/j.nanoen.2025.110765>

<span id="ref-133"></span>**\[133\]** Wilkinson, M. D.; Dumontier, M.; Aalbersberg, I. J. et al. The FAIR Guiding Principles for scientific data management and stewardship. Sci. Data 2016, 3, 160018. <https://doi.org/10.1038/sdata.2016.18>

<span id="ref-134"></span>**\[134\]** Lookman, T.; Balachandran, P. V.; Xue, D.; Yuan, R. Active learning in materials science with emphasis on adaptive sampling using uncertainties for targeted design. npj Comput. Mater. 2019, 5, 21. <https://doi.org/10.1038/s41524-019-0153-8>

<span id="ref-135"></span>**\[135\]** Shahriari, B.; Swersky, K.; Wang, Z.; Adams, R. P.; de Freitas, N. Taking the human out of the loop: a review of Bayesian optimization. Proc. IEEE 2016, 104 (1), 148–175. <https://doi.org/10.1109/JPROC.2015.2494218>

<span id="ref-136"></span>**\[136\]** Balandat, M.; Karrer, B.; Jiang, D. R.; Daulton, S.; Letham, B.; Wilson, A. G.; Bakshy, E. BoTorch: a framework for efficient Monte-Carlo Bayesian optimization. In Advances in Neural Information Processing Systems 33 (NeurIPS 2020); arXiv:1910.06403.

<span id="ref-137"></span>**\[137\]** Cao, L.; Russo, D.; Felton, K.; Salley, D.; Sharma, A.; Keenan, G.; Mauer, W.; Gao, H.; Cronin, L.; Lapkin, A. A. Optimization of formulations using robotic experiments driven by machine learning DoE. Cell Rep. Phys. Sci. 2021, 2 (1), 100295. <https://doi.org/10.1016/j.xcrp.2020.100295>

<span id="ref-138"></span>**\[138\]** OpenAI. GPT-4 Technical Report. arXiv:2303.08774, 2023.

<span id="ref-139"></span>**\[139\]** Anthropic. The Claude 3 Model Family: Opus, Sonnet, Haiku; model card, 2024. <https://www.anthropic.com/news/claude-3-family> (accessed 2026).

<span id="ref-140"></span>**\[140\]** Zhou, J.; Luo, M.; Chen, L.; Zhu, Q.; Jiang, S.; Zhang, F.; Shang, W.; Jiang, J. A multi-robot–multi-task scheduling system for autonomous chemistry laboratories. Digital Discovery 2025, 4 (3), 636–652. <https://doi.org/10.1039/D4DD00313F>

<span id="ref-141"></span>**\[141\]** Panapitiya, G.; Saldanha, E.; Job, H.; Hess, O. AutoLabs: cognitive multi-agent systems with self-correction for autonomous chemical experimentation. Sci. Rep. 2026, 16 (1), 19554. <https://doi.org/10.1038/s41598-026-45593-z>

<span id="ref-142"></span>**\[142\]** Rupprecht, S.; Gao, Q.; Karia, T.; Schweidtmann, A. M. Multi-agent systems for chemical engineering: a review and perspective. Curr. Opin. Chem. Eng. 2026, 51, 101209. <https://www.sciencedirect.com/science/article/pii/S2211339825001212> (preprint: arXiv:2508.07880)

<span id="ref-143"></span>**\[143\]** Roch, L. M.; Häse, F.; Kreisbeck, C.; Tamayo-Mendoza, T.; Yunker, L. P. E.; Hein, J. E.; Aspuru-Guzik, A. ChemOS: an orchestration software to democratize autonomous discovery. PLoS ONE 2020, 15 (4), e0229862. <https://doi.org/10.1371/journal.pone.0229862>

<span id="ref-144"></span>**\[144\]** Sim, M.; Vakili, M. G.; Strieth-Kalthoff, F.; Hao, H.; Hickman, R. J.; Miret, S.; Pablo-García, S.; Aspuru-Guzik, A. ChemOS 2.0: an orchestration architecture for chemical self-driving laboratories. Matter 2024, 7 (9), 2959–2977. <https://doi.org/10.1016/j.matt.2024.04.022>

<span id="ref-145"></span>**\[145\]** Brohan, A.; Brown, N.; Carbajal, J. et al. RT-2: vision-language-action models transfer web knowledge to robotic control. In Proc. 7th Conference on Robot Learning (CoRL 2023), PMLR vol. 229; arXiv:2307.15818.

<span id="ref-146"></span>**\[146\]** Chi, C.; Xu, Z.; Feng, S.; Cousineau, E.; Du, Y.; Burchfiel, B.; Tedrake, R.; Song, S. Diffusion policy: visuomotor policy learning via action diffusion. Int. J. Robot. Res. 2025, 44 (10–11), 1684–1704. <https://doi.org/10.1177/02783649241273668>

<span id="ref-147"></span>**\[147\]** Octo Model Team; Ghosh, D.; Walke, H.; Pertsch, K. et al. Octo: an open-source generalist robot policy. In Proc. Robotics: Science and Systems (RSS 2024); arXiv:2405.12213.

<span id="ref-148"></span>**\[148\]** Kim, M. J.; Pertsch, K.; Karamcheti, S. et al. OpenVLA: an open-source vision-language-action model. In Proc. 8th Conference on Robot Learning (CoRL 2024); arXiv:2406.09246.

<span id="ref-149"></span>**\[149\]** Ai, B.; Tian, S.; Shi, H. et al. A review of learning-based dynamics models for robotic manipulation. Sci. Robot. 2025, 10 (106), eadt1497. <https://doi.org/10.1126/scirobotics.adt1497>

<span id="ref-150"></span>**\[150\]** Ren, Y.; Liu, Z.; Chen, X. et al. LabVLA: grounding vision-language-action models in scientific laboratories. arXiv:2606.13578, 2026.

<span id="ref-151"></span>**\[151\]** Nelder, J. A.; Mead, R. A simplex method for function minimization. Comput. J. 1965, 7 (4), 308–313. <https://doi.org/10.1093/comjnl/7.4.308>

<span id="ref-152"></span>**\[152\]** Chemspeed Technologies AG. FLEX FORMAX automated formulation workstation; product page. <https://www.chemspeed.com> (accessed 2026).

<span id="ref-153"></span>**\[153\]** Jain, A.; Ong, S. P.; Chen, W. et al. FireWorks: a dynamic workflow system designed for high-throughput applications. Concurr. Comput.: Pract. Exper. 2015, 27 (17), 5037–5059. <https://doi.org/10.1002/cpe.3505>

<span id="ref-154"></span>**\[154\]** Huber, S. P.; Zoupanos, S.; Uhrin, M. et al. AiiDA 1.0, a scalable computational infrastructure for automated reproducible workflows and data provenance. Sci. Data 2020, 7, 300. <https://doi.org/10.1038/s41597-020-00638-4>

<span id="ref-155"></span>**\[155\]** Mehr, S. H. M.; Craven, M.; Leonov, A. I.; Keenan, G.; Cronin, L. A universal system for digitization and automatic execution of the chemical synthesis literature. Science 2020, 370 (6512), 101–108. <https://doi.org/10.1126/science.abc2986>

<span id="ref-156"></span>**\[156\]** Vogler, M.; Busk, J.; Hajiyani, H. et al. Brokering between tenants for an international materials acceleration platform. Matter 2023, 6 (9), 2647–2665. <https://doi.org/10.1016/j.matt.2023.07.016>

<span id="ref-157"></span>**\[157\]** Allan, D.; Caswell, T.; Campbell, S.; Rakitin, M. Bluesky’s ahead: a multi-facility collaboration for an a la carte software project for data acquisition and management. Synchrotron Radiat. News 2019, 32 (3), 19–22. <https://doi.org/10.1080/08940886.2019.1608121>

<span id="ref-158"></span>**\[158\]** Lewis, R. D.; Ginsburg, T. S.; Ozgulbas, D.; Stone, C.; Stroka, A.; Cleary, A.; Foster, I. T.; Paulson, N. MADSci: a modular Python-based framework to enable autonomous science. J. Open Source Softw. 2026, 11 (119), 9416. <https://doi.org/10.21105/joss.09416>

<span id="ref-159"></span>**\[159\]** Fei, Y.; Rendy, B.; Kumar, R. et al. AlabOS: a Python-based reconfigurable workflow management framework for autonomous laboratories. Digital Discovery 2024, 3 (11), 2275–2288. <https://doi.org/10.1039/D4DD00129J>

<span id="ref-160"></span>**\[160\]** Angelopoulos, A.; Baykal, C.; Kandel, J.; Verber, M.; Cahoon, J. F.; Alterovitz, R. The Experiment Orchestration System (EOS): comprehensive foundation for laboratory automation. In 2025 IEEE International Conference on Robotics and Automation (ICRA); IEEE, 2025; pp 15900–15906. <https://doi.org/10.1109/ICRA55743.2025.11128578>

<span id="ref-161"></span>**\[161\]** Guevarra, D.; Kan, K.; Lai, Y.; Jones, R. J. R.; Zhou, L.; Donnelly, P.; Richter, M.; Stein, H. S.; Gregoire, J. M. Orchestrating nimble experiments across interconnected labs. Digital Discovery 2023, 2 (6), 1806–1812. <https://doi.org/10.1039/D3DD00166K>

<span id="ref-162"></span>**\[162\]** Zhang, W.; Hao, L.; Lai, V. et al. IvoryOS: an interoperable web interface for orchestrating Python-based self-driving laboratories. Nat. Commun. 2025, 16, 5182. <https://doi.org/10.1038/s41467-025-60514-w>

<span id="ref-163"></span>**\[163\]** Gao, J.; Chang, J.; Que, H. et al. UniLabOS: an AI-native operating system for autonomous laboratories. arXiv 2025, arXiv:2512.21766. <https://doi.org/10.48550/arXiv.2512.21766>

<span id="ref-164"></span>**\[164\]** Tamura, R.; Yoshikawa, N.; Tsuda, K.; Matsuda, S. NIMO: a software platform for closed-loop materials exploration with diverse AI algorithms. Digital Discovery 2026. <https://doi.org/10.1039/D6DD00371K>

<span id="ref-165"></span>**\[165\]** Air Force Research Laboratory. ARES OS 2.0: autonomous self-driving laboratory orchestration software; software repository. <https://github.com/AFRL-ARES/ARES> (accessed 2026).

<span id="ref-166"></span>**\[166\]** Yoo, H. J.; Lee, K.-Y.; Kim, D.; Han, S. S. OCTOPUS: operation control system for task optimization and job parallelization via a user-optimal scheduler. Nat. Commun. 2024, 15, 9669. <https://doi.org/10.1038/s41467-024-54067-7>

<span id="ref-167"></span>**\[167\]** Juchli, D. SiLA 2: the next generation lab automation standard. Adv. Biochem. Eng./Biotechnol. 2022, 147–174. <https://doi.org/10.1007/10_2022_204>

<span id="ref-168"></span>**\[168\]** Brendel, A.; Dorfmüller, F.; Liebscher, A.; Kraus, P.; Kress, K.; Oehme, H.; Arnold, M.; Koschitzki, R. Laboratory and Analytical Device Standard (LADS): a communication standard based on OPC UA for networked laboratories. Adv. Biochem. Eng./Biotechnol. 2022, 175–194. <https://doi.org/10.1007/10_2022_209>

<span id="ref-169"></span>**\[169\]** AnIML Working Group. AnIML: Analytical Information Markup Language, an open XML format for analytical data; specification. <https://www.animl.org> (accessed 2026).

<span id="ref-170"></span>**\[170\]** Allotrope Foundation. Allotrope Data Format and Allotrope Simple Model; data standards. <https://www.allotrope.org> (accessed 2026).

<span id="ref-171"></span>**\[171\]** Anthropic. Model Context Protocol (MCP); specification. <https://modelcontextprotocol.io/specification/2025-06-18> (accessed 2026).

<span id="ref-172"></span>**\[172\]** Darvish, K.; Skreta, M.; Zhao, Y. et al. ORGANA: a robotic assistant for automated chemistry experimentation and characterization. Matter 2025, 8 (2), 101897. <https://doi.org/10.1016/j.matt.2024.10.015>

<span id="ref-173"></span>**\[173\]** Zou, Y.; Cheng, A. H.; Aldossary, A. et al. El Agente: an autonomous agent for quantum chemistry. Matter 2025, 8 (7), 102263. <https://doi.org/10.1016/j.matt.2025.102263>

<span id="ref-174"></span>**\[174\]** Müller, M.; Bai, J.; Gottstein, W. et al. La Agente Óptima: towards agentic self-driving laboratories. arXiv 2026, arXiv:2609.04564. <https://doi.org/10.48550/arXiv.2609.04564>

<span id="ref-175"></span>**\[175\]** Song, T.; Luo, M.; Zhang, X. et al. A multiagent-driven robotic AI chemist enabling autonomous chemical research on demand. J. Am. Chem. Soc. 2025, 147 (15), 12534–12545. <https://doi.org/10.1021/jacs.4c17738>

<span id="ref-176"></span>**\[176\]** Ruan, Y.; Lu, C.; Xu, N. et al. An automatic end-to-end chemical synthesis development platform powered by large language models. Nat. Commun. 2024, 15, 10160. <https://doi.org/10.1038/s41467-024-54457-x>

<span id="ref-177"></span>**\[177\]** Mandal, I.; Soni, J.; Zaki, M. et al. Evaluating large language model agents for automation of atomic force microscopy. Nat. Commun. 2025, 16, 9104. <https://doi.org/10.1038/s41467-025-64105-7>

<span id="ref-178"></span>**\[178\]** Zhang, Z.; Ren, Z.; Hsu, C.-W. et al. A multimodal robotic platform for multi-element electrocatalyst discovery. Nature 2025, 647 (8089), 390–396. <https://doi.org/10.1038/s41586-025-09640-5>

</div>
