mahdi-rstgr/formulation-sdl-atlas/wiki-src/docs/ai/index.md

# AI Infrastructure for Autonomous Material Handling

!!! info "Updated to manuscript V3"

    The review places AI at **step 7 (Decide)**, above a stack of hardware, simulation and orchestration. New pages: [Data & Decision Models](data-and-decisions.md) (what an experiment records; surrogates and acquisition), [LLMs & AI Agents](agents.md) (agent roles, autonomy levels and safeguards, Table 7), [Simulation & Digital Twins](../simulation/index.md) and [Orchestration](../orchestration/index.md) (functional layers L1–L4 and interfaces such as SiLA 2, ROS 2 and MCP). The "Integration Architecture" section below is the earlier wiki's view; the review's layered architecture is on the orchestration page.

## Overview

This section describes the AI and control systems that enable autonomous material handling: sensing, feedback control, machine learning, and digital twins.

## Why AI Infrastructure Matters

Raw hardware (pumps, motors, grippers) is necessary but not sufficient for autonomous handling. Intelligence comes from:

1. **Sensing:** Measuring material properties and process state in real time
2. **Feedback control:** Adjusting equipment parameters based on sensor feedback
3. **Machine learning:** Generalizing from past experience to new materials
4. **Digital twins:** Simulating outcomes before physical execution
5. **LLM agents:** Reasoning about complex tasks and adapting plans

These components together create the "intelligence" that allows a robot to handle 1000 different materials without re-tuning per material.

---

## The AI Stack for Material Handling

```
User / Request
       ↓
   LLM Agent (Strategy Selection)
       ↓
Machine Learning Model (Parameter Prediction)
       ↓
Control System (PID loop, real-time correction)
       ↓
Sensors (Feedback: weight, force, pressure, vision)
       ↓
Hardware (Robot, pump, gripper)
       ↓
Material (Liquid, powder, solid)
```

---

## Sensing Layer

**Purpose:** Gather information about material properties and process state

**Sensor types:**
- Gravimetric (load cell, balance)
- Force/torque (F/T sensors)
- Pressure (transducers)
- Vision (cameras, depth sensors)
- Proprioceptive (joint angles, motor current)
- Environmental (temperature, humidity)

**Sampling rates:** 10 Hz – 1 kHz (depending on process speed)

**See:** [Sensing & Characterization](sensing.md)

---

## Feedback Control Layer

**Purpose:** Real-time adjustment of equipment parameters to maintain desired outcome

**Control strategies:**
- Proportional-Integral-Derivative (PID)
- Force control
- Impedance control
- Adaptive control (parameters change based on material)

**Typical loop rate:** 100 Hz – 1 kHz

**See:** [Feedback Control](feedback-control.md)

---

## Machine Learning Layer

**Purpose:** Learn from past experience; generalize to new materials

**ML techniques:**
- Regression (linear, polynomial, neural networks)
- Classification (decision trees, random forests)
- Unsupervised (clustering, dimensionality reduction)
- Reinforcement learning (trial-and-error policy learning)

**Training data required:** 20–500 examples (depends on problem complexity)

**See:** [Machine Learning](machine-learning.md)

---

## Digital Twins & Simulation

**Purpose:** Predict outcomes before executing; train models; understand failure modes

**Simulator technologies:**
- Discrete element method (DEM) for powders
- Finite element method (FEM) for liquids/gels
- Rigid body dynamics for solid handling
- Fluid-structure interaction (FSI) for complex flows

**See:** [Digital Twins & LLMs](digital-twins.md)

---

## Integration Architecture

### Monolithic Approach (Single Language/Framework)

All AI components in one codebase (Python + TensorFlow + ROS):
- Pros: Fast integration, unified logging
- Cons: Rigid, hard to replace individual components

### Microservices Approach (Modular)

Separate services (sensing, ML, control) communicate via API:
- Pros: Flexible, scalable, easy to replace/upgrade
- Cons: Networking overhead, more complex deployment

### Hybrid Approach (Recommended)

- **Core control loop:** ROS (robotics middleware)
- **ML models:** TensorFlow/PyTorch (containerized)
- **Simulation:** OpenFOAM (separate compute)
- **LLM reasoning:** API call to GPT-4 or Claude (cloud)

---

## Example: Closed-Loop Powder Dispensing

```
Step 1: Sense initial state
  └─ Measure: powder properties (size, density, friction)
  └─ Sensor: rheometer, sieve, scales (takes 2–5 min)

Step 2: Predict parameters via ML
  └─ Input: [size, density, friction]
  └─ Model: trained neural network
  └─ Output: suggested auger speed = 35 rpm ✓

Step 3: Execute with feedback control
  └─ Set auger speed to 35 rpm
  └─ Monitor weight in real time (load cell, 100 Hz)
  └─ PID control: if weight lagging, increase speed; if leading, decrease speed
  └─ Duration: 20 seconds
  └─ Result: 5.0 ± 0.05 g delivered ✓
```

---

## Data Flow and Latency Requirements

### Process Duration: 5–30 seconds

- **Sensor latency budget:** < 100 ms (feedback must be fast)
- **ML inference time:** < 10 ms (quick prediction)
- **Control update rate:** 100 Hz = 10 ms per cycle

### Total system latency

- Sensing: 10 ms
- ML inference: 5 ms
- Control computation: 5 ms
- Actuator response: 50 ms
- **Total: ~70 ms latency** (acceptable for most processes)

---

## Common Pitfalls

### 1. Misalignment Between Sensor & Control

**Problem:** Sensor accuracy is ±2%, but control target is ±1%

**Solution:** Ensure sensor is 5× more accurate than control requirement

### 2. Over-Reliance on ML Without Validation

**Problem:** Train ML model on simulated data, deploy to real hardware → 20% error

**Solution:** Always validate ML model on 5–20 real samples before full deployment

### 3. Control Loop Tuning

**Problem:** PID gains are "magic numbers"; no one knows how to adjust them

**Solution:** Use Ziegler-Nichols or model-based tuning method; document gains

### 4. Sensor Drift

**Problem:** Load cell calibration drifts over weeks; measurements become unreliable

**Solution:** Calibrate sensors weekly; implement drift detection (compare to reference)

---

## Next Steps

Explore each layer in depth:

- [Sensing & Characterization](sensing.md) — How to measure material properties
- [Feedback Control](feedback-control.md) — How to implement real-time control loops
- [Machine Learning](machine-learning.md) — How to train models for material handling
- [Digital Twins & LLMs](digital-twins.md) — How to simulate and reason about tasks

---

## References

- Rastegardoost, M. M.; Bao, Z.; Sadr, S.; Abdollahi, N.; Darvish, K.; Clasky, A.; Ohsaka, H.; Le Devedec, F. *Self-Driving Laboratories for Formulation: Handling Liquids, Pastes, Powders and Objects, from Robots to Digital Twins and AI Agents.* Manuscript in preparation, 2026.
- Key references from the review: [\[96\]](../references.md#ref-96), [\[125\]](../references.md#ref-125), [\[127\]](../references.md#ref-127), [\[133\]](../references.md#ref-133), [\[135\]](../references.md#ref-135), [\[171\]](../references.md#ref-171). Full list on the [References](../references.md) page.

### Further reading (from the earlier wiki)

- Siciliano, B., & Khatib, O. (Eds.). (2016). *Springer Handbook of Robotics* (2nd ed.). Springer.
- Bishop, C. M. (2006). *Pattern Recognition and Machine Learning*. Springer.
- Åström, K. J., & Murray, R. M. (2010). *Feedback Systems: An Introduction for Scientists and Engineers*. Princeton University Press.
