mahdi-rstgr/formulation-sdl-atlas/wiki-src/docs/outlook/future-directions.md

# Future Directions & Emerging Technologies

!!! info "Outlook from the V3 review"

    **Three lessons.** (1) Every material class now has methods that sense, model or correct its dispensing, yet viscous pastes and cohesive powders are where these methods generalize least. (2) Progress comes from co-designing hardware and software, as in liquid handlers that integrate viscometry and new actuation [\[22\]](../references.md#ref-22), [\[23\]](../references.md#ref-23), [\[25\]](../references.md#ref-25), [\[27\]](../references.md#ref-27) and powder dispensers pairing real-time imaging with simulation-trained control [\[12\]](../references.md#ref-12), [\[38\]](../references.md#ref-38). (3) Object handling and the commercial market lag behind SDL research: accuracy is published where handling is easy and rarely where it is hard, prices hide behind quotes, and many capabilities exist only as single-laboratory retrofits.

    **What is missing is integration.** No platform yet takes an unfamiliar set of ingredients, decides how to dose each, assembles the premix, moves it through mixing and characterization and learns from the result. Methods that transfer across materials by construction point the way: physics-informed parameter identification for pastes [\[32\]](../references.md#ref-32), RL policies that reach unseen powders [\[38\]](../references.md#ref-38), and visuomotor policies, dynamics models and vision-language-action foundation models [\[145\]](../references.md#ref-145), [\[146\]](../references.md#ref-146), [\[147\]](../references.md#ref-147), [\[148\]](../references.md#ref-148), [\[149\]](../references.md#ref-149), [\[150\]](../references.md#ref-150). Slow characterization (e.g. long-term stability), numerical representation of mixtures and, for drug products, in vitro–in vivo correlation are further open problems.

    **Four directions.** *Shared benchmarks* (reference liquids, pastes, powders and premix-transfer tasks with reported error); *open interfaces* (hardware-agnostic control layers, orchestration software with standard resource models, APIs and FAIR data pipelines with published accuracy and price); *calibrated twins* (material and workcell models identified from a few in-situ observations and validated against the cell); and *safeguards that scale with autonomy* [\[129\]](../references.md#ref-129), [\[130\]](../references.md#ref-130). Landmark platforms [\[3\]](../references.md#ref-3), [\[4\]](../references.md#ref-4), [\[57\]](../references.md#ref-57) show that handling is a first-class research problem revisited at every scale-up.

## Overview

The field of autonomous material handling is rapidly evolving. This page highlights emerging technologies, open research questions, and the likely trajectory of the field over the next 5–10 years.

---

## Near-Term Improvements (1–3 Years)

### 1. Tighter Integration of ML & Control

**Current state:** ML predicts nominal parameters; PID loop handles real-time correction

**Future:** ML learns the control policy directly (end-to-end learning)

**Example:**

```
Current: viscosity → speed (ML) → PID feedback loop
Future: viscosity + weight_history → speed_trajectory (ML) as function of time

Benefit: Can learn non-linear control laws (e.g., initial speed fast, then ramp down)
```

**Timeline:** 2–3 years; requires good simulation or extensive real data

---

### 2. Multi-Material Handling in Single Task

**Current state:** Each material requires separate characterization + optimization

**Future:** System detects material change mid-task, adapts strategy seamlessly

**Example:**

```
Pharmaceutical coating process:
  - Tablet core (hard solid): use Strategy 7 (tactile pick)
  - Coating liquid (Newtonian): use Strategy 1 (characterize)
  - Drying powder (cohesive): use Strategy 3 (real-time correction)

System recognizes material transition, switches strategy automatically
```

**Timeline:** 2–3 years; requires robust material detection

---

### 3. Soft & Compliant Robots

**Current state:** Rigid robots with force limits (hard to control gently)

**Future:** Inherently compliant mechanisms (soft actuators, flexible joints)

**Benefit:** Lower injury risk; better adaptation to object shape

**Examples:**
- Soft pneumatic grippers (silicone + tendon actuation)
- Series elastic actuators (spring between motor and tool)
- Continuum robots (snake-like, no rigid joints)

**Timeline:** 3–5 years before commercial viability

---

### 4. Real-Time Rheometry & On-the-Fly Characterization

**Current state:** Separate lab rheometer; slow (5–10 min per material)

**Future:** Micro-rheometer integrated into dispensing head; characterizes while dispensing

**Benefit:** No separate characterization step; continuous property monitoring

**Technologies:**
- MEMS viscosity sensors (piezoelectric, vibrational)
- Microfluidic rheometry (pressure drop over known geometry)
- Spectroscopy-on-a-chip (miniaturized UV-Vis)

**Timeline:** 2–3 years to market

---

## Medium-Term Paradigm Shifts (3–7 Years)

### 1. From Reactive to Predictive Control

**Current:** System responds to errors (reactive)

**Future:** System predicts errors before they occur (predictive)

**Example:**

```
Reactive: Weight is 4.8 g → increase speed
Predictive: ML predicts weight will be 4.8 g in 2 seconds → adjust speed now

Benefit: Fewer oscillations, faster settling, higher throughput
```

**Enabling tech:** Better models, faster sensors, learned dynamics

---

### 2. Heterogeneous Robot Teams

**Current state:** Single robot handling single material type

**Future:** Team of specialized robots (liquid handler, powder dispenser, gripper) working on same product

**Example:**

```
Manufacturing cell:
  Robot A: liquid extrusion (high-precision ink printer)
  Robot B: powder sprinkling (vibratory feeder + vision)
  Robot C: solid assembly (grasping, placing)

All coordinated by central AI, no human intervention
```

**Challenges:**
- Scheduling (which robot does what, when)
- Collision avoidance (multiple robots in same space)
- Error recovery (if Robot A fails, who detects? Who fixes?)

**Timeline:** 5–7 years for production-ready systems

---

### 3. Autonomous Design & Hardware Optimization

**Current:** Hardware is fixed; only software/control is optimized

**Future:** Hardware is re-designed on-the-fly (3D printing, modular components)

**Example:**

```
System encounters new cohesive powder:
  - Recognizes standard auger feeder will fail
  - Designs new screw geometry (variable pitch)
  - 3D prints new screw in 2 hours
  - Swaps out screw, continues operation

Benefit: Handles previously "impossible" materials without human engineering
```

**Enabling tech:**
- Rapid prototyping (fast 3D printing)
- Design automation (generative design via AI)
- Modular hardware (standardized interfaces)

**Timeline:** 5–10 years (very speculative)

---

### 4. Digital Twin Fidelity & Validation

**Current state:** Simulators are approximate (±5–20% error)

**Future:** Simulators are high-fidelity (±1–2% error), automatically validated against real data

**Example:**

```
System dispenses 100 batches:
  - Simulation predicts: 5.0 ± 0.1 g
  - Reality measures: 5.02 ± 0.08 g
  - Discrepancy: < 0.5%, simulator validated ✓
  - Next 900 batches: use ML model trained on simulation (no real testing)
```

**Enabling tech:**
- Automated calibration (sensor data fed back to simulator)
- Differentiable physics (compute gradient of error w.r.t. simulator parameters)

**Timeline:** 3–5 years

---

## Long-Term Vision (7–15 Years)

### 1. General-Purpose Autonomous Labs

**Vision:** Robot laboratory that can handle any material handling task without human reprogramming

**Requirements:**
- Universally accurate material characterization (can measure anything)
- Generalist robot (can handle liquids, powders, solids via different tools)
- Robust AI (understands when it doesn't know, asks human or escalates)
- Safety guarantees (can prove system won't harm anyone)

**Challenges:**
- Physics + materials science knowledge must be encoded in AI
- Rare materials will still need characterization
- Safety validation becomes exponentially harder

**Timeline:** 10–15 years; requires breakthroughs in robotics + ML

---

### 2. Human-Robot Collaboration (HRC) for High-Value Tasks

**Vision:** Human expert + robot assistant team for precision work

**Example:**

```
Pharmaceutical researcher + robot:
  Human: "I have 50 APIs. Screen them for ideal dissolving conditions."
  Robot: "I'll run 50 tests overnight. You arrive tomorrow and interpret results."

Robot automates:
  - Liquid handling (dispense solvent)
  - Solid handling (place tablet)
  - Measurement (UV-Vis absorption over time)
  - Data logging

Human provides:
  - Judgment (is this actually dissolved or just suspended?)
  - Design of next experiments
  - Problem-solving (something weird happened; why?)
```

**Benefit:** 100× increase in throughput; human cognition + robot speed

**Timeline:** 5–10 years; driven by demand for high-throughput screening

---

### 3. Active Learning & Online Adaptation

**Vision:** System learns continuously from every action, improves automatically

**Example:**

```
Monday: System dispenses 1000 batches; learns patterns from successes/failures

Tuesday: System is 5% more accurate than Monday (learned optimal speed trajectory)

Friday: System is 15% more accurate than Monday (learned material-specific patterns)

No human intervention; just continuous improvement
```

**Enabling tech:**
- Bayesian optimization (intelligently choose next experiment to maximize learning)
- Transfer learning (apply lessons from one material to new materials)
- Few-shot learning (learn from just 3–5 examples)

**Timeline:** 5–7 years for basic capability; 10+ years for robust systems

---

### 4. Autonomous Troubleshooting & Maintenance

**Vision:** System detects its own problems, diagnoses root cause, fixes autonomously

**Example:**

```
System detects:
  - Accuracy drift: 3 weeks of data shows systematic trend
  - Diagnosis: pressure transducer drifts due to temperature
  - Action: automatically recalibrates sensor using known standard

All without human discovery or intervention
```

**Enabling tech:**
- Fault diagnosis algorithms (FMEA-based, data-driven)
- Autonomous maintenance (robot that can disassemble, replace, reassemble)

**Timeline:** 7–10 years

---

## Open Research Questions

### Fundamental Science

1. **Universal material model:** Can we describe all materials (liquid, powder, solid) in a unified framework?
2. **Generalization limits:** How many materials must we train on to achieve >95% accuracy on unseen materials?
3. **Optimal control theory:** What is the theoretically optimal strategy for unknown material?

### Engineering

1. **Robustness to uncertainty:** Can we guarantee safety even if we don't know material properties exactly?
2. **Real-time learning:** How fast can we adapt to new materials? (hours? minutes? seconds?)
3. **Hardware-software co-design:** Which problems are better solved with new hardware vs. better software?

### AI/ML

1. **Sim-to-real transfer:** How to train in simulation without expensive real-world validation?
2. **Sample efficiency:** Can we learn from just 1–5 real examples (few-shot learning)?
3. **Explainability:** Can we understand why ML model made a particular prediction?

### Human Factors

1. **Trust calibration:** How to make humans trust autonomous systems appropriately (not over-trust, not under-trust)?
2. **Handoff protocols:** When should the human take over? When should robot try harder?
3. **Failure modes:** What happens when system confidence is high but accuracy is low?

---

## Impact on Different Sectors

### Pharmaceuticals

**Current:** Manual characterization + optimization takes 1–2 hours per new formulation

**Future (5 years):** Automated system optimizes in 10–15 minutes; 10× throughput improvement

**Impact:** Accelerated drug development, faster time-to-market, lower costs

---

### Food & Cosmetics

**Current:** Trained operators manually adjust equipment for each batch; recipe is experience-based

**Future (7 years):** AI system learns optimal recipe; reproducible across all plants; no operator skill needed

**Impact:** Reduced variation, higher quality, easier to scale globally

---

### Materials Science

**Current:** Researchers manually synthesize materials, test properties, iterate

**Future (5–10 years):** Autonomous lab synthesizes 10–100 new materials/day, tests properties, learns patterns

**Impact:** 100× acceleration in materials discovery (inspired by AlphaFold success in protein structure)

---

### Biotech & Cell Therapy

**Current:** Handling cells requires human expertise; cell damage risk → lower yield

**Future (3–5 years):** Gentle soft robots with tactile feedback handle cells automatically; higher yield, reproducible

**Impact:** More affordable cell therapies; accessible to more patients

---

## Emerging Technologies to Watch

### Hardware

- **Soft actuators:** Dielectric elastomer actuators (DEAs), twisted & coiled polymers
- **Smart materials:** Self-healing polymers (fix wear automatically), shape-memory alloys (adapt geometry)
- **Modular end-effectors:** Quick-change tools (one robot, many tasks)

### Sensing

- **Biocompatible sensors:** Implantable, flexible; measure cell properties in situ
- **Optical sensing:** Spectroscopy-on-chip, label-free biosensors
- **Distributed sensing:** 1000s of tiny sensors across robot (full tactile coverage)

### AI/ML

- **Foundation models:** Pre-train on huge material handling dataset, fine-tune for specific task
- **Physics-informed neural networks (PINNs):** Embed physics knowledge into ML models
- **Continual learning:** Learn continuously without forgetting past knowledge

---

## Recommendations for Researchers

### If You Want to Contribute

1. **Simulation validation:** Build high-fidelity simulators for your material; validate against real data
2. **Few-shot learning:** Can a pre-trained model work on new materials with just 3–5 examples?
3. **Robust control:** Design controllers that work even if material properties are uncertain
4. **Hardware innovation:** Design grippers/dispensers that work for a wider range of materials
5. **Safety:** Prove that your autonomous system is safe (formal methods, testing)

### Key Datasets Needed

- Powder flow data (100+ powder types, comprehensive characterization + dispensing results)
- Liquid rheology (temperature-dependent, shear-dependent, aging effects)
- Grasp success/failure (10,000+ examples of objects, gripper configurations, outcomes)
- Real-world deployment logs (actual system performance over months/years)

---

## Conclusion

Material handling is poised for a revolution similar to autonomous vehicles: from manual, operator-dependent systems to intelligent, self-optimizing systems that can handle diverse materials with minimal human intervention.

The 7 strategies described in this wiki are the foundation. The next 10 years will focus on:

1. **Integration:** Seamlessly switching between strategies within a single system
2. **Generalization:** Learning from diverse materials to handle new ones with high confidence
3. **Autonomy:** Minimal human oversight; system troubleshoots and adapts on its own
4. **Safety:** Formal guarantees that autonomous systems won't harm people or products

The future belongs to labs and manufacturers that embrace these technologies early.

---

## References

- Rastegardoost, M. M.; Bao, Z.; Sadr, S.; Abdollahi, N.; Darvish, K.; Clasky, A.; Ohsaka, H.; Le Devedec, F. *Self-Driving Laboratories for Formulation: Handling Liquids, Pastes, Powders and Objects, from Robots to Digital Twins and AI Agents.* Manuscript in preparation, 2026.
- Key references from the review: [\[1\]](../references.md#ref-1), [\[3\]](../references.md#ref-3), [\[4\]](../references.md#ref-4), [\[8\]](../references.md#ref-8), [\[32\]](../references.md#ref-32), [\[38\]](../references.md#ref-38), [\[57\]](../references.md#ref-57), [\[129\]](../references.md#ref-129), [\[130\]](../references.md#ref-130), [\[145\]](../references.md#ref-145), [\[146\]](../references.md#ref-146), [\[147\]](../references.md#ref-147), [\[148\]](../references.md#ref-148), [\[149\]](../references.md#ref-149), [\[150\]](../references.md#ref-150). Full list on the [References](../references.md) page.

### Further reading (from the earlier wiki)

- Silver, D., Huang, A., Maddison, C. J., et al. (2016). Mastering the game of Go with deep neural networks and tree search. *Nature*, 529, 484–489.
- Jumper, J., et al. (2021). Highly accurate protein structure prediction with AlphaFold. *Nature*, 596, 583–589.
- Barto, A. G., & Sutton, R. S. (2018). *Reinforcement Learning: An Introduction* (2nd ed.). MIT Press.
