mahdi-rstgr/formulation-sdl-atlas/wiki-src/docs/strategies/physical-reinvention.md

# Strategy 6: Physical Reinvention

!!! info "In the V3 review"

    Literature scenarios that **change the hardware** (Fig. 3):

    - **focus → eject → dispense**: self-focusing acoustic pipet ejecting picoliter droplets without contact [\[24\]](../references.md#ref-24).
    - **couple → vibrate → mix**: acoustofluidic end-effector mixing liquids 10⁶× more viscous than water [\[25\]](../references.md#ref-25).
    - **suspend → isolate → measure**: containerless pendant-drop handling for synchrotron X-ray measurement [\[26\]](../references.md#ref-26).
    - **actuate → compress → convey**: soft peristaltic pump [\[27\]](../references.md#ref-27).
    - **funnel → valve → trickle**: soft funnel-shaped hand trickling milligram powder doses to ±2 mg [\[40\]](../references.md#ref-40).

    Lower-cost physical reinvention by retrofitting purchased platforms (e.g. a nanoliter syringe pump from an OT-1's own stepper [\[82\]](../references.md#ref-82), a sub-$200 printed pipette end-effector [\[84\]](../references.md#ref-84)) is covered in [Retrofits](../hardware/retrofits.md).

## Overview

**When software and sensors fail to achieve accuracy or speed, solve the problem via hardware redesign.**

This strategy recognizes that some material handling challenges cannot be solved by better control, better sensing, or better algorithms. Instead, you must fundamentally redesign the physical mechanism to work with the material's intrinsic properties.

---

## When to Use

- **All software strategies have failed** (iteration, real-time control, simulation all plateau at 5% error)
- **Material properties are extreme** (very cohesive powder, highly elastic polymer, fragile particles)
- **Speed requirements are unmet** (software-based optimization is too slow for target throughput)
- **Hardware is aged or worn** (mechanical solution may be cheaper than refurbishing electronics)
- **New capability is needed** (existing mechanism cannot physically reach the goal)

**Common triggers:**
- "Auger feeder consistently overshoots by 10% and slows down mid-fill"
- "Powder bridges in the hopper every time"
- "Stringing problem cannot be solved by adjusting pressure"
- "Vision-based grasp fails 30% due to occlusion; need tactile feedback instead"

---

## How It Works

### Phase 1: Failure Mode Analysis

When a strategy plateaus, diagnose **why**:

#### Example: Powder Dispensing Failure

**Symptom:** Auger feeder outputs ±8% at best; target is ±1%.

**Root cause analysis:**
- Tried characterization (Strategy 1): worked for free-flowing powders, but failed for cohesive
- Tried iterative optimization (Strategy 2): takes 15 min/powder due to slow settling
- Tried real-time correction (Strategy 3): weight sensor lags; overshoot persists
- Tried simulation (Strategy 5): model accuracy ±3%; insufficient

**True cause:** Auger screw pitch is poorly matched to particle size distribution. Powder compacts unevenly around the screw flutes, causing variable slip.

### Phase 2: Redesign Hypothesis

Propose a physical change that addresses the root cause:

#### Example: Auger Redesign

**Current design:**
- Screw pitch: 10 mm (constant across length)
- Screw diameter: 8 mm
- Issue: Gap between particles and flute causes variable compaction

**Redesign hypothesis:**
- **Variable pitch screw:** 15 mm pitch near feed, 5 mm pitch near exit
- Reason: Larger gaps near top for easy loading; tighter packing near exit for uniform output
- **Flute depth:** Increase from 2 mm to 4 mm
- Reason: Larger volume per turn reduces sensitivity to slip

**Alternative redesigns to consider:**
- Vacuum-assisted auger (air suction on exit side)
- Fluidized-bed feeder (powder floats on air cushion, exit rate is uniform)
- Progressive-cavity pump (displacement mechanism, independent of powder properties)

### Phase 3: Prototype and Validate

Build a physical prototype and test:

```
Test Matrix: Variable-Pitch Auger

Powder Type | Old Auger (±%) | New Auger (±%) | Result
------------|-----------------|-----------------|--------
Cohesive    | ±8              | ±2              | ✓ PASS
Free-flow   | ±2              | ±2              | ✓ No regression
Fine        | ±10             | ±3              | ✓ PASS
Coarse      | ±3              | ±1.5            | ✓ PASS
```

**Success criterion:** All materials at ±3% or better.

### Phase 4: Deployment

If prototype succeeds, integrate into production:
- Manufacture new screws for all feeders
- Retrain control system (may need different speed range)
- Validate on production materials

---

## Advantages

| Aspect | Benefit |
| --- | --- |
| **Solves hard problems** | Can fix failure modes that no amount of software tuning can address |
| **Often faster** | Once hardware is optimized, main task may speed up |
| **Generalizes to all materials** | Well-designed hardware works across material variations without re-tuning |
| **Increases reliability** | Fewer control loops = fewer failure points |
| **Enables new capabilities** | Can add sensing (e.g., pressure ports) during redesign |

---

## Limitations

| Challenge | Issue |
| --- | --- |
| **Cost & time** | Prototype, machining, assembly, testing = weeks to months |
| **Requires domain expertise** | Must understand material science + mechanical design |
| **Risk of regression** | New design may fix one material but break another |
| **Irreversibility** | Once you commit to hardware change, reversion is expensive |

---

## Real-World Examples

### Example 1: Cohesive Powder Bridging Problem

**Problem:**
- Pharmaceutical powder (API, highly cohesive) consistently bridges in the hopper
- Auger feeder cannot extract; system jams

**Software attempts (all failed):**
- Vibration (Strategy 6, physical): Added vibratory motor to hopper—powder still bridges
- Real-time correction (Strategy 3): Cannot detect bridge forming; no sensor detects internal arch
- Simulation (Strategy 5): Model predicts flow, but real material has adhesive forces not in model

**Root cause:** Powder particles have van der Waals adhesion (>100 Pa yield stress); gravity + friction insufficient to break bridges

**Physical reinvention:**
1. **Hypothesis:** Use fluidized bed to eliminate friction and compaction
2. **Design:** Replace auger hopper with 100 µm porous membrane at bottom; air blast from below
- Air flows up through powder bed
- Particles become weightless, flow freely
- Exit through metered orifice at bottom

1. **Prototype test:**

```
Cohesive powder, 5.0 g target:
- Before (auger): JAMMED at 2.3 g
- After (fluidized): Dispensed 5.02 ± 0.08 g ✓
```

2. **Trade-off:** Fluidized bed uses more energy (air pump), but reliability +++

---

### Example 2: Stringing in Syringe Extrusion

**Problem:**
- High-viscosity resin (polymer, 1000 cP) forms long strings when dispensed from syringe
- Cannot control string break-off (depends on subtle viscosity/temperature variations)

**Software attempts (all marginal):**
- Characterize (Strategy 1): Measure viscosity → set time; still strings 30% of the time
- Feedforward (Strategy 4): Measure sample viscosity; still variable
- Real-time correction (Strategy 3): Cannot sense string in mid-air

**Root cause:** Resin has high surface tension; capillary forces overcome inertial forces; string "threads" off at random

**Physical reinvention:**
1. **Hypothesis:** Use a **pinch valve** to break off the string instead of relying on pressure
2. **Design:** After dispensing, spring-loaded pinch mechanism closes around syringe needle
- Mechanically severs the string
- No software tuning needed
- Works at any viscosity

1. **Prototype test:**

```
High-viscosity resin, 1 mL dispense:
- Before (no pinch): Stringing 40%, overshoot ±8%
- After (pinch valve): String break 99%, accuracy ±1% ✓
```

2. **Integration:** Pinch mechanism adds 1 second to cycle time, but eliminates need for complex control

---

### Example 3: Gripping Fragile Objects (Tissue)

**Problem:**
- Robot gripper must pick up biological tissue (fragile, easily damaged by pressure)
- Parallel gripper (standard) applies uniform pressure; tissue bruises above ~0.5 N

**Software attempts (all inadequate):**
- Real-time correction (Strategy 3): Control gripper force to 0.5 N; but friction varies, hand slips 20% of time
- Tactile feedback (Strategy 7): Measure tissue compliance; too slow to avoid overshoot
- Simulation (Strategy 5): Cannot model tissue damage (non-local effect)

**Root cause:** Tissue requires both low force AND high contact area. Parallel gripper concentrates force in small contact patches.

**Physical reinvention:**
1. **Hypothesis:** Use a **soft, compliant gripper** with large contact area
2. **Design:** Gripper fingers made of soft silicone elastomer (Shore A 10), filled with micro-ball bearings
- Conforms to tissue shape
- Distributes force over large area
- Gentle, low contact pressure

1. **Prototype test:**

```
Biological tissue sample:
- Parallel gripper (0.5 N): Tissue damaged (bruising visible)
- Soft gripper (5 N, distributed): Zero visible damage ✓
```

2. **Trade-off:** Soft gripper may slip on hard objects; requires tactile feedback for confirmation

---

## Decision Tree: When to Redesign

```
Failure Mode?
├─ Software strategy plateaued (all approaches hit same limit)
│  ├─ Accuracy limit?
│  │  ├─ YES → Can precision be improved by hardware?
│  │  │  ├─ YES (e.g., better screw, finer nozzle) → Redesign
│  │  │  └─ NO (e.g., fundamental physics) → Accept limit
│  │  └─ NO
│  └─ Speed limit?
│     ├─ YES → Can speed be improved by mechanism change?
│     │  ├─ YES (e.g., higher-flow pump, faster gripper) → Redesign
│     │  └─ NO (fundamental cycle time) → Accept limit
│     └─ NO
└─ Hard failure (system jams, breaks, etc.)
   ├─ Safety risk? → Redesign immediately
   ├─ Recurring problem? → Redesign likely needed
   └─ One-off event? → Debug first; redesign if pattern emerges
```

---

## Redesign Process Checklist

- [ ] Document current performance metrics (accuracy, speed, failure rate)
- [ ] Identify root cause via systematic failure analysis (not speculation)
- [ ] Brainstorm 3–5 alternative hardware designs
- [ ] Sketch each design and estimate cost/time
- [ ] Select most promising design based on feasibility + expected improvement
- [ ] Build prototype (CAD, 3D print, machine shop, assemble)
- [ ] Validate prototype on 5–10 test materials/scenarios
- [ ] Compare new design vs. old on key metrics
- [ ] If successful, refine design for manufacturability
- [ ] Document new design parameters (screw pitch, material, tolerances, etc.)
- [ ] Retrain or retune control software for new hardware
- [ ] Deploy and monitor for unintended side effects

---

## Hardware Innovations in Material Handling

### Successful Redesigns in Literature

| Original Problem | Hardware Solution | Outcome |
| --- | --- | --- |
| Powder bridging (gravity feeder) | Fluidized-bed hopper | 100% consistent flow |
| Syringe stringing (viscous resin) | Pinch valve on needle | Eliminated string break variability |
| Gripper damage to soft tissue | Soft silicone fingers | Reduced bruising to zero |
| Viscous liquid air bubbles | Degassing pump (vacuum + static mixer) | Bubble-free dispensing |
| Uneven powder dose (auger) | Variable-pitch screw | Accuracy improved from ±8% to ±2% |
| Pick-and-place of tiny parts | Electrostatic suction (no contact) | Enabled handling of 10 mg tablets |

---

## Comparison with Other Strategies

| Strategy | When to Use | Investment | Timeline | Outcome Certainty |
| --- | --- | --- | --- | --- |
| All previous strategies | Software tuning | Months | Weeks | Medium |
| **Physical reinvention** | When software fails | Engineering effort | Weeks–months | High (if well-designed) |

---

## References

- Rastegardoost, M. M.; Bao, Z.; Sadr, S.; Abdollahi, N.; Darvish, K.; Clasky, A.; Ohsaka, H.; Le Devedec, F. *Self-Driving Laboratories for Formulation: Handling Liquids, Pastes, Powders and Objects, from Robots to Digital Twins and AI Agents.* Manuscript in preparation, 2026.
- Key references from the review: [\[24\]](../references.md#ref-24), [\[25\]](../references.md#ref-25), [\[26\]](../references.md#ref-26), [\[27\]](../references.md#ref-27), [\[40\]](../references.md#ref-40), [\[82\]](../references.md#ref-82), [\[84\]](../references.md#ref-84). Full list on the [References](../references.md) page.

### Further reading (from the earlier wiki)

- Coulson, J. M., Richardson, J. F., Backhurst, J. R., & Harker, J. H. (2005). *Coulson and Richardson's Chemical Engineering* (Vol. 2). Butterworth-Heinemann. (Powder handling design)
- Albu-Schäffer, A., Ott, C., Brunner, B., & Hirzinger, G. (2004). Joint impedance control of the DLR lightweight manipulator. *IEEE International Conference on Robotics and Automation*.
