mahdi-rstgr/formulation-sdl-atlas/wiki-src/docs/strategies/simulation-generalization.md

# Strategy 5: Simulation-Based Generalization

!!! info "In the V3 review"

    Literature scenarios that **generalize through simulation** (Fig. 3):

    - **poke → simulate → identify**: a differentiable-physics twin recovers a paste's yield stress, modulus and friction from poking, generalizing across materials [\[32\]](../references.md#ref-32).
    - **scoop → dump → transfer**: a policy trained entirely in simulation transfers to unseen powders without retuning [\[38\]](../references.md#ref-38).
    - **measure → calibrate → dispense**: a simulator calibrated from measured flowability generalizes to unseen cohesive powders [\[39\]](../references.md#ref-39).
    - **scoop → transport → pour**: three chainable RL policies bootstrapped from a differentiable granular simulator [\[41\]](../references.md#ref-41).

    DEM contact parameters must be calibrated from bulk tests [\[121\]](../references.md#ref-121), [\[122\]](../references.md#ref-122), and the sim-to-real gap [\[128\]](../references.md#ref-128) grows with rheological complexity. See [Simulation & Digital Twins](../simulation/index.md).

## Overview

**Train a machine learning model in simulation on many materials, then deploy to real hardware to handle unseen materials with minimal tuning.**

This strategy tackles the problem of material diversity by using simulation as a "data factory": instead of measuring and optimizing for every material, train a model on a diverse population of simulated materials, then trust the model to generalize to real materials.

---

## When to Use

- **Many untrained materials** (100+ powder types, liquid formulations, etc.)
- **Measurement is hard or slow** (material characterization takes hours)
- **Physics is well-understood** (you can build a simulator)
- **Simulation correlates with reality** (validated on 5–20 real materials)
- **Time budget is tight** (want to dispense in seconds, not minutes)
- **Robustness matters** (want the system to work on the first try)

**Common applications:**
- Autonomous pharmaceutical labs (need to handle any API powder)
- Formulation discovery (test 1000s of new compositions)
- Chemical synthesis (material properties unknown upfront)
- Food/cosmetic manufacturing (ingredient variation)
- Robotics (deploy gripper to handle any object shape, without learning each one)

---

## How It Works

### Step 1: Build a Physics Simulator

Create a simulation of the material handling task:

#### For Powder Dispensing

```
Simulator inputs:
  - Particle size distribution (PSD): mean, std
  - Particle density: ρ (kg/m³)
  - Friction coefficient: μ (particle-particle, particle-wall)
  - Cohesion (van der Waals): cohesive energy
  - Moisture content: w (%)
  - Auger screw pitch, speed: p, ω (rpm)

Simulator (discrete element method, DEM):
  - Initialize N = 10,000 particles
  - Simulate gravity + friction
  - Rotate auger; particles slide out
  - Count particles exiting per second

Output:
  - Mass dispensed as function of time: M(t)
  - Final accuracy: σ (std deviation)
```

#### For Liquid Extrusion

```
Simulator inputs:
  - Viscosity: η (cP)
  - Yield stress: τ_y (Pa)
  - Surface tension: γ (N/m)
  - Nozzle diameter: d (mm)
  - Applied pressure: P (kPa)
  - Extrusion time: t (s)

Simulator (finite element method, FEM):
  - Solve Navier-Stokes with yield-stress model
  - Compute flow rate Q(P, η, τ_y)
  - Output: Volume dispensed V = Q × t
```

### Step 2: Generate Synthetic Training Data

Run the simulator on a **diverse population of materials**:

```
For i = 1 to 500:
  Sample material parameters randomly:
    viscosity ~ LogNormal(1 cP, 100 cP)
    yield_stress ~ LogNormal(0 Pa, 100 Pa)
    particle_size ~ LogNormal(10 µm, 500 µm)
    friction ~ Uniform(0.2, 0.8)

  Run simulator with these parameters
  Record: (inputs) → (optimal_control_parameter)

Result: 500 (material, optimal_parameter) pairs
```

This creates a training dataset without touching a single real material.

### Step 3: Train a Machine Learning Model

Map material properties → optimal control parameters:

$$
\text{optimal\_parameter} = f_\theta(\text{material\_properties})
$$

**Model architectures:**

- **Neural network (most common):**

```
Input: [viscosity, yield_stress, size, friction]
Hidden: 128 → 64 → 32 neurons
Output: [pump_speed, pressure]
Activation: ReLU
```

- **Random forest:**

```
100 decision trees, each depth 10
Handles non-linearity well
```

- **Gaussian process:**

```
Slower to train, but provides uncertainty estimates
```

### Step 4: Validate Simulation vs. Reality

Before deploying, verify the simulator is accurate:

1. **Pick 5 real materials** spanning the parameter space
2. **Measure their properties** (viscosity, size, etc.)
3. **Run simulator + trained model** to predict optimal parameters
4. **Test on real hardware** at predicted parameters
5. **Compare:** simulated prediction vs. real outcome
6. If error < 10%, simulator is trusted
7. If error > 20%, simulator needs recalibration

### Step 5: Deploy to Production

For a new, untrained material:

1. **Characterize quickly** (measure viscosity, size, friction in 1–2 min)
2. **Plug into trained model** → get predicted optimal parameters
3. **Execute on robot** (no iteration, one-pass)
4. **Log result** for future simulator improvements

---

## Advantages

| Aspect | Benefit |
| --- | --- |
| **Generalization** | Model trained on 500 simulated materials handles 10,000 real ones |
| **Speed** | No iterative tuning; main task is one-pass (30 sec) |
| **Scalability** | Works for continuous product variations and new formulations |
| **Robustness** | Diverse training data → model is less brittle |
| **Knowledge transfer** | Train once, deploy across multiple sites/robots |

---

## Limitations

| Challenge | Issue |
| --- | --- |
| **Simulator accuracy** | If physics is wrong, model inherits errors (GIGO principle) |
| **Domain gap** | Real materials may have properties outside training domain |
| **Validation overhead** | Need to validate simulator on real materials first (weeks of work) |
| **Model interpretability** | Neural networks are black boxes; hard to debug |
| **Retraining cost** | If deployment fails systematically, retraining the model is slow |

---

## Real-World Examples

### Example 1: Powder Dispensing for Pharmaceutical Manufacturing

**Problem:** Pharmaceutical company has 200 different API powders, each with unique properties. Auger feeder produces ±5% error without tuning. Goal: ±1% error for all 200 APIs.

**Solution: Simulation-Based Generalization**

**Phase 1: Simulator Development (2 weeks)**
- Obtain 10 representative APIs
- Measure: PSD, density, moisture, friction, cohesion
- Calibrate DEM simulator to match experimental flow rates
- Validation: simulator predicts actual mass within ±3% ✓

**Phase 2: Synthetic Data Generation (1 day)**
- Sample 500 material compositions: size 10–500 µm, density 0.8–2.5 g/cm³, friction 0.2–0.8
- Run DEM simulator on each
- Record optimal auger speed for ±1% accuracy

**Phase 3: Model Training (2 days)**
- Train neural network: [size, density, friction] → [auger_speed]
- Validation accuracy: ±2% on held-out simulator data

**Phase 4: Validation on Real APIs (3 days)**
- Test on 5 new APIs (not in simulator training)
- Predict speed, test on hardware: 4/5 within ±1.5%, 1/5 outside (systematic bias in API#3)
- Recalibrate simulator for cohesive powders

**Phase 5: Deployment (Ongoing)**

```
For each new API batch:
  1. Measure: PSD, moisture (5 min via standard protocol)
  2. Predict: auger_speed using model (< 1 sec)
  3. Dispense: 5.0 g at predicted speed (30 sec)
  4. Verify: weight → ±0.8% ✓ (meets spec)
  5. Log data (for future model retraining)
```

**Outcome:** All 200 APIs dispensed at ±1% accuracy with zero manual tuning per API. Time saved: ~100 hours/month vs. manual optimization.

---

### Example 2: Automated Robotic Grasping for Bin Picking

**Problem:** Robot hand must pick up different objects (varying shape, size, material) from a disordered bin. Each object requires 20 minutes of manual force/finger-angle tuning. Goal: Grasp any object in 5 seconds.

**Solution: Simulation-Based Generalization**

**Phase 1: Physics Simulator (3 weeks)**
- Build 3D object models (50 representative shapes: cylinders, boxes, irregular solids)
- Integrate friction model (µ depends on material: rubber 0.8, plastic 0.4, glass 0.1)
- Simulate finger closing, measure contact forces and grasp stability

**Phase 2: Synthetic Data (2 days)**
- Generate 10,000 random 3D objects (procedurally deformed, size 2–50 cm)
- Sample friction, weight, center-of-mass
- Simulate grasp for each: test 100 finger-angle configurations
- Record: (object_shape, material) → (best_finger_angles, grip_force)

**Phase 3: Model Training (3 days)**
- Encode object shape as voxel grid or point cloud
- Train convolutional neural network: (shape, friction) → (finger_angles, force)
- Test accuracy: 92% of grasps stable on held-out shapes

**Phase 4: Real-World Validation (1 week)**
- Test on 10 real objects with varying shapes/materials
- 8/10 grasps succeed on first try, 2/10 require one manual correction
- Retrain on failure cases

**Phase 5: Deployment (Ongoing)**

```
For each bin-picking task:
  1. Robot vision: detect object, estimate shape and material
  2. Predict: finger angles + grip force from trained model (< 100 ms)
  3. Grasp: execute predicted configuration (2 seconds)
  4. Lift: if object slips, activate real-time correction (Strategy 3)
  5. Log for model improvement
```

**Outcome:** 95% bin-picking success rate, 5-second average cycle time, zero manual tuning per object.

---

### Example 3: Liquid-Liquid Extraction Optimization

**Problem:** Pharmaceutical extraction uses solvent A, solvent B, and aqueous phase. Efficiency depends on solvent ratios and mixing time. Manual optimization takes 2 hours per formulation.

**Solution: Simulation-Based Generalization**

**Phase 1: Computational Fluid Dynamics (CFD) Simulator (4 weeks)**
- Build 3D model of mixing vessel, pumps, settling chamber
- Implement two-phase flow equations with mass transfer kinetics
- Validate on 3 reference formulations

**Phase 2: Synthetic Data (2 days)**
- Parametrize by: solvent_A_ratio (0.1–0.9), solvent_B_ratio (0.05–0.5), temperature (20–40°C), mixing_time (1–30 min)
- Run CFD on 500 combinations
- Output: extraction_efficiency, settling_time, phase_purity

**Phase 3: Model Training (2 days)**
- Train Gaussian process: (ratio_A, ratio_B, temp, time) → (efficiency, purity)
- Provides uncertainty bounds

**Phase 4: Real-World Validation (1 week)**
- Test 10 new formulations: predict optimal parameters, measure actual efficiency
- Model predictions within 5% of reality for 8/10 formulations
- Retrain

**Phase 5: Deployment (Ongoing)**

```
For each new formulation:
  1. Measure: target extraction efficiency, product purity spec
  2. Predict: optimal solvent ratios, temperature, mixing time (< 1 sec)
  3. Execute: run extraction at predicted parameters (30 min process)
  4. Verify: measure final efficiency → log for model improvement
```

**Outcome:** Average optimization time reduces from 2 hours to 30 minutes (CFD run time). Future formulations optimized in seconds.

---

## Building a Simulator: Practical Steps

### 1. Identify the Physics

- Fluid mechanics? (extrusion, pumping)
- Particle dynamics? (powder, granular)
- Solid mechanics? (gripper, compliance)
- Multi-phase? (emulsions, suspensions)

### 2. Choose a Simulation Tool

| Tool | Language | Use Case |
| --- | --- | --- |
| COMSOL | MATLAB | CFD, multiphysics |
| OpenFOAM | C++ | Fluid mechanics, open-source |
| LIGGGHTS/LAMMPS | C++ | Granular flow (DEM) |
| Bullet Physics | C++ | Rigid body dynamics |
| Isaac Sim / PyBullet | Python | Robotics, vision-based grasping |
| Abaqus/FEA | CAD-integrated | Complex solid mechanics |

### 3. Validate Against Real Data

Run 5–20 real experiments, compare simulator predictions:
- If error < 10%: simulator is ready
- If error 10–20%: recalibrate parameters (friction, density, etc.)
- If error > 20%: missing physics (e.g., surface tension, adhesion); revisit model

### 4. Generate Synthetic Data

Sample random parameters uniformly or from a distribution, run simulator.

### 5. Train & Deploy

Train model, validate, integrate into control software.

---

## Implementation Checklist

- [ ] Select material handling task and identify governing physics
- [ ] Build or adapt a physics simulator
- [ ] Validate simulator on 5–20 real materials (< 10% error target)
- [ ] Parametrize material properties (viscosity, size, friction, etc.)
- [ ] Generate synthetic data: 200–1000 material samples
- [ ] Select ML architecture (neural network, random forest, or Gaussian process)
- [ ] Train model on synthetic data (80% train, 20% validation)
- [ ] Validate on held-out real materials
- [ ] If validation error > 5%, recalibrate simulator or retrain
- [ ] Integrate model into robot/equipment control software
- [ ] Deploy and log outcomes for continuous improvement
- [ ] Quarterly: retrain model with accumulated real-world data

---

## Comparison with Other Strategies

| Strategy | Training Time | Deployment Time | Accuracy | Generalization | Complexity |
| --- | --- | --- | --- | --- | --- |
| Characterize, then act | None | 2–5 min | ±5% | Poor | Low |
| Iterative optimization | None | 15–30 min | ±1% | Per-material | Medium |
| Real-time correction | None | 5–30 sec | ±2% | Medium | High |
| Feedforward prediction | 1–2 weeks | 2–5 min | ±2% | Medium | High |
| **Simulation generalization** | 4–8 weeks | 1–5 min | ±3% | Excellent | Very high |

---

## References

- Rastegardoost, M. M.; Bao, Z.; Sadr, S.; Abdollahi, N.; Darvish, K.; Clasky, A.; Ohsaka, H.; Le Devedec, F. *Self-Driving Laboratories for Formulation: Handling Liquids, Pastes, Powders and Objects, from Robots to Digital Twins and AI Agents.* Manuscript in preparation, 2026.
- Key references from the review: [\[32\]](../references.md#ref-32), [\[38\]](../references.md#ref-38), [\[39\]](../references.md#ref-39), [\[41\]](../references.md#ref-41), [\[121\]](../references.md#ref-121), [\[122\]](../references.md#ref-122), [\[128\]](../references.md#ref-128). Full list on the [References](../references.md) page.

### Further reading (from the earlier wiki)

- Cundall, P. A., & Strack, O. D. (1979). A discrete numerical model for granular assemblies. *Géotechnique*, 29(1), 47–65. (DEM foundations)
- Goodfellow, I., Bengio, Y., & Courville, A. (2016). *Deep Learning*. MIT Press. (Neural networks)
