mahdi-rstgr/formulation-sdl-atlas/assets/img/chemlab/agilent-gc8890b.webp

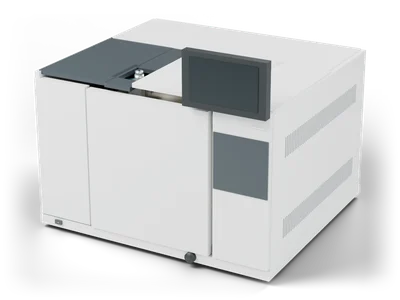
assets/img/chemlab/agilent-gc8890b.webp
