mahdi-rstgr/formulation-sdl-atlas/assets/img/chemlab/agilent-hs8697.webp

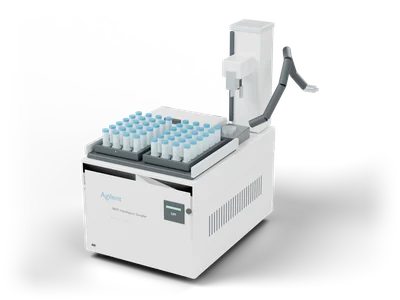
assets/img/chemlab/agilent-hs8697.webp
