mahdi-rstgr/formulation-sdl-atlas/assets/img/chemlab/aqualab-4te.webp

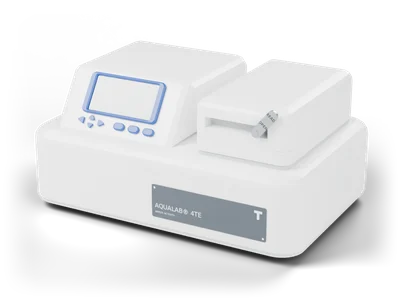
assets/img/chemlab/aqualab-4te.webp
