mahdi-rstgr/formulation-sdl-atlas/assets/img/chemlab/azenta-intellixcap-s1-46-0001.webp

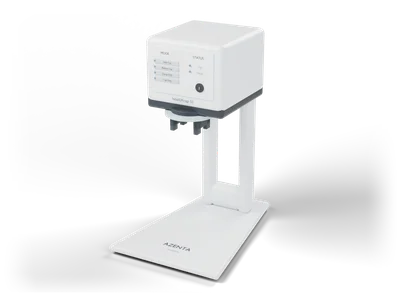
assets/img/chemlab/azenta-intellixcap-s1-46-0001.webp
