mahdi-rstgr/formulation-sdl-atlas/assets/img/chemlab/biotage-extrahera-classic.webp

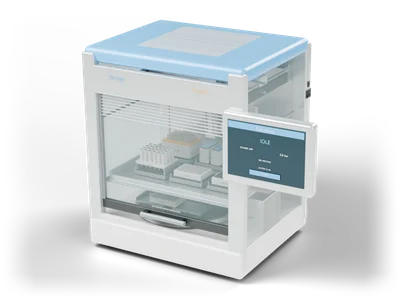
assets/img/chemlab/biotage-extrahera-classic.webp
