mahdi-rstgr/formulation-sdl-atlas/assets/img/chemlab/bronkhorst-p702cv-5bar-gauge-n2.webp

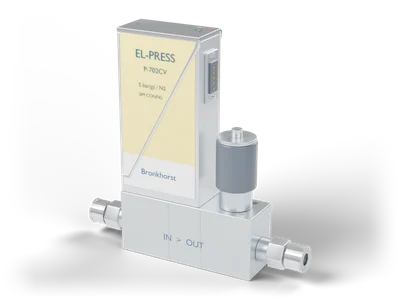
assets/img/chemlab/bronkhorst-p702cv-5bar-gauge-n2.webp
