mahdi-rstgr/formulation-sdl-atlas/assets/img/chemlab/eco-ncld822.webp

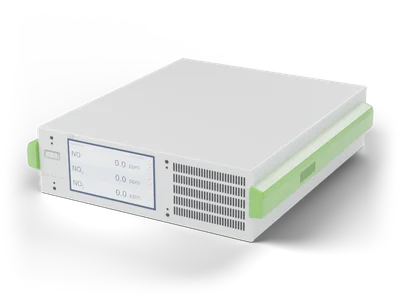
assets/img/chemlab/eco-ncld822.webp
