mahdi-rstgr/formulation-sdl-atlas/assets/img/chemlab/hach-dr6000.webp

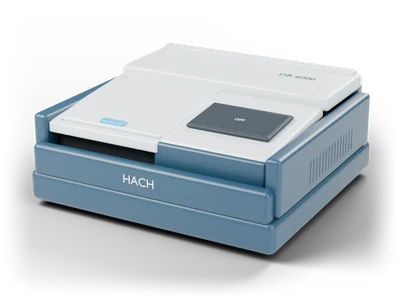
assets/img/chemlab/hach-dr6000.webp
