mahdi-rstgr/formulation-sdl-atlas/assets/img/chemlab/hach-tl2300epa.webp

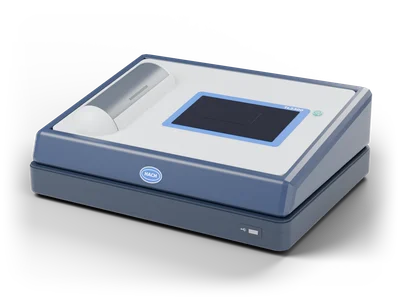
assets/img/chemlab/hach-tl2300epa.webp
