mahdi-rstgr/formulation-sdl-atlas/assets/img/chemlab/hepatochem-photoredoxbox.webp

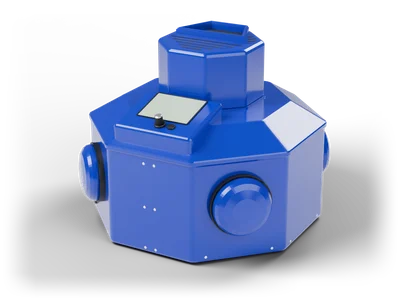
assets/img/chemlab/hepatochem-photoredoxbox.webp
