mahdi-rstgr/formulation-sdl-atlas/assets/img/chemlab/ika-rv10-digital-v.webp

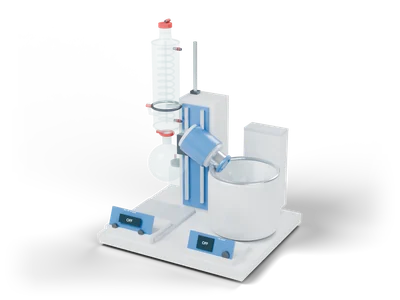
assets/img/chemlab/ika-rv10-digital-v.webp
