mahdi-rstgr/formulation-sdl-atlas/assets/img/chemlab/inert-purelab-he-2gb.webp

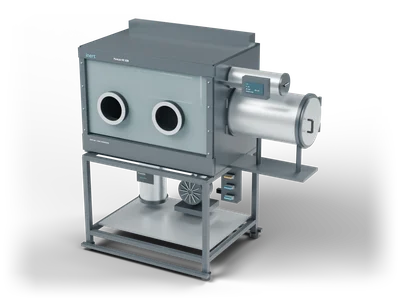
assets/img/chemlab/inert-purelab-he-2gb.webp
