mahdi-rstgr/formulation-sdl-atlas/assets/img/chemlab/jeol-jem1400flash.webp

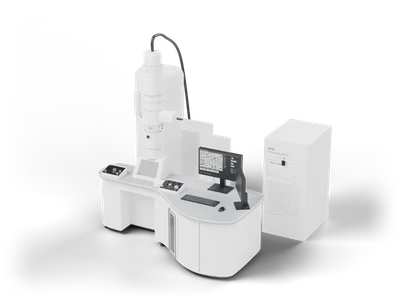
assets/img/chemlab/jeol-jem1400flash.webp
