mahdi-rstgr/formulation-sdl-atlas/assets/img/chemlab/metrohm-914.webp

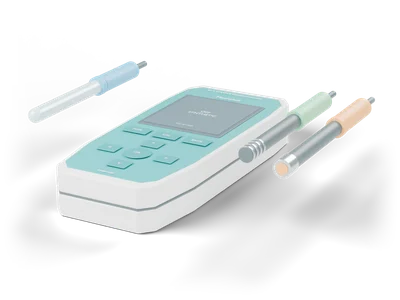
assets/img/chemlab/metrohm-914.webp
