mahdi-rstgr/formulation-sdl-atlas/assets/img/chemlab/miele-plw6111.webp

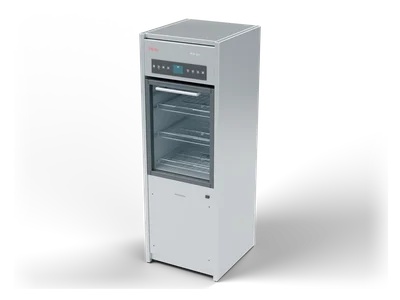
assets/img/chemlab/miele-plw6111.webp
