mahdi-rstgr/formulation-sdl-atlas/assets/img/chemlab/milestone-dma80.webp

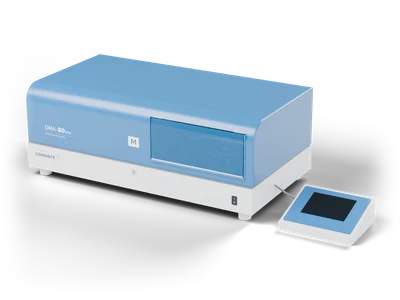
assets/img/chemlab/milestone-dma80.webp
