mahdi-rstgr/formulation-sdl-atlas/assets/img/chemlab/mt-xpr204e.webp

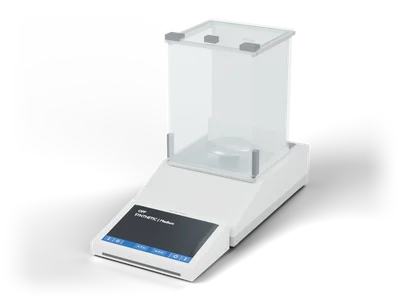
assets/img/chemlab/mt-xpr204e.webp
