mahdi-rstgr/formulation-sdl-atlas/assets/img/chemlab/nabertherm-l9.webp

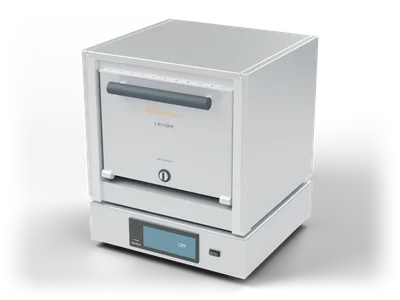
assets/img/chemlab/nabertherm-l9.webp
