mahdi-rstgr/formulation-sdl-atlas/assets/img/chemlab/parr-4591.webp

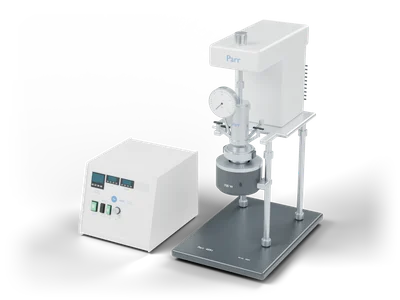
assets/img/chemlab/parr-4591.webp
