mahdi-rstgr/formulation-sdl-atlas/assets/img/chemlab/thermo-dionexintegrion.webp

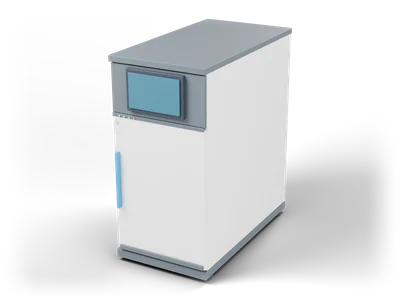
assets/img/chemlab/thermo-dionexintegrion.webp
