mahdi-rstgr/formulation-sdl-atlas/assets/img/chemlab/vacuubrand-pc3001-vario-select.webp

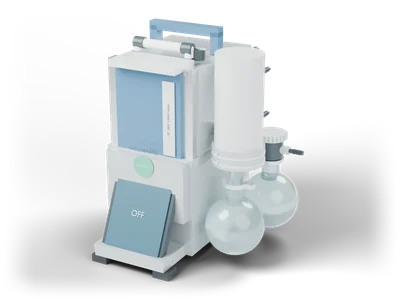
assets/img/chemlab/vacuubrand-pc3001-vario-select.webp
