mahdi-rstgr/formulation-sdl-atlas/assets/img/chemlab/vici-euta-2sd6mwe.webp

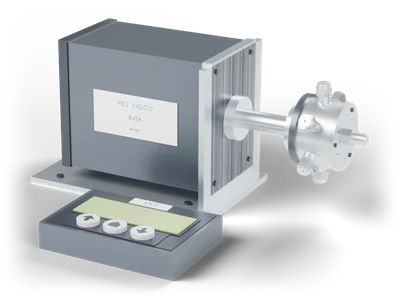
assets/img/chemlab/vici-euta-2sd6mwe.webp
