mahdi-rstgr/formulation-sdl-atlas/assets/img/formulator/cell-front.webp

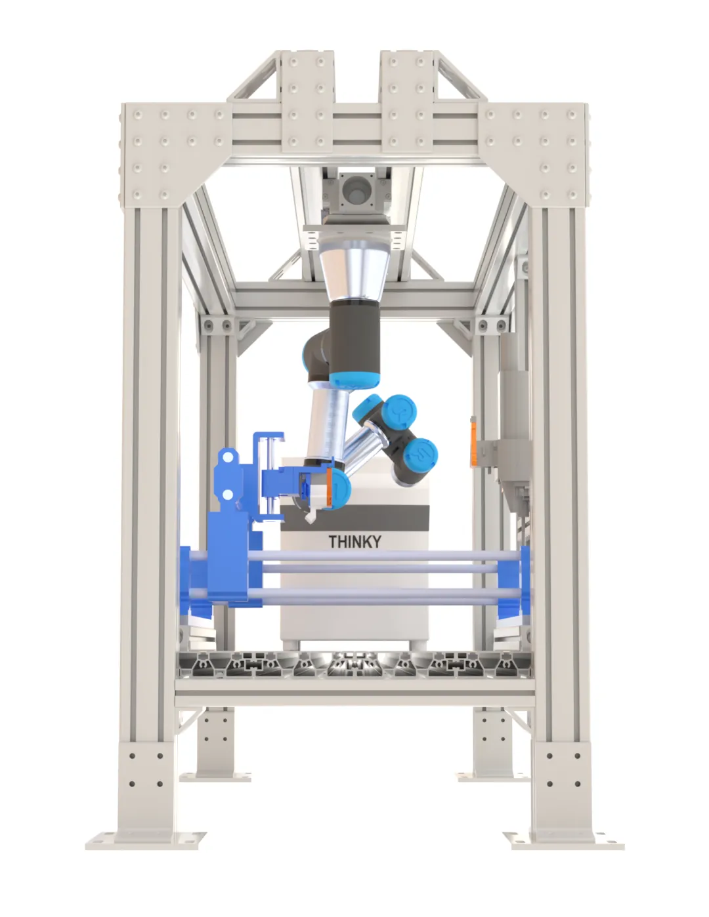
assets/img/formulator/cell-front.webp
