mahdi-rstgr/formulation-sdl-atlas/assets/img/formulator/cell-perspective.webp

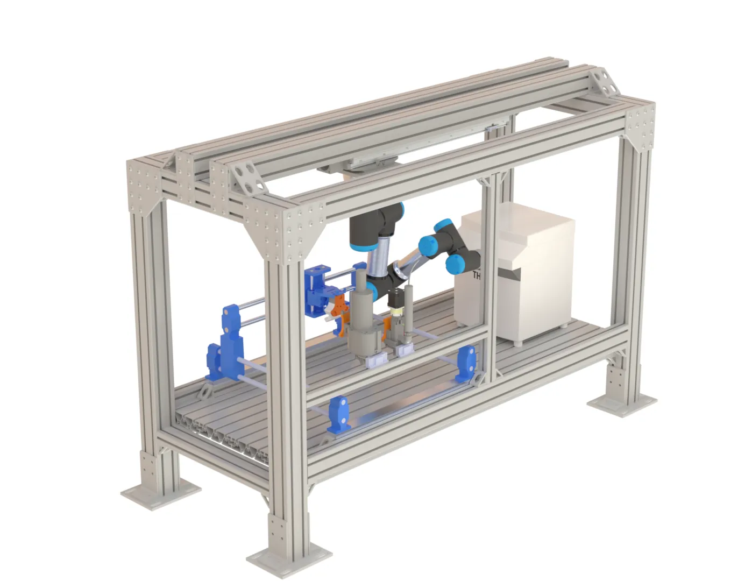
assets/img/formulator/cell-perspective.webp
