mahdi-rstgr/formulation-sdl-atlas/assets/img/formulator/cell-side.webp

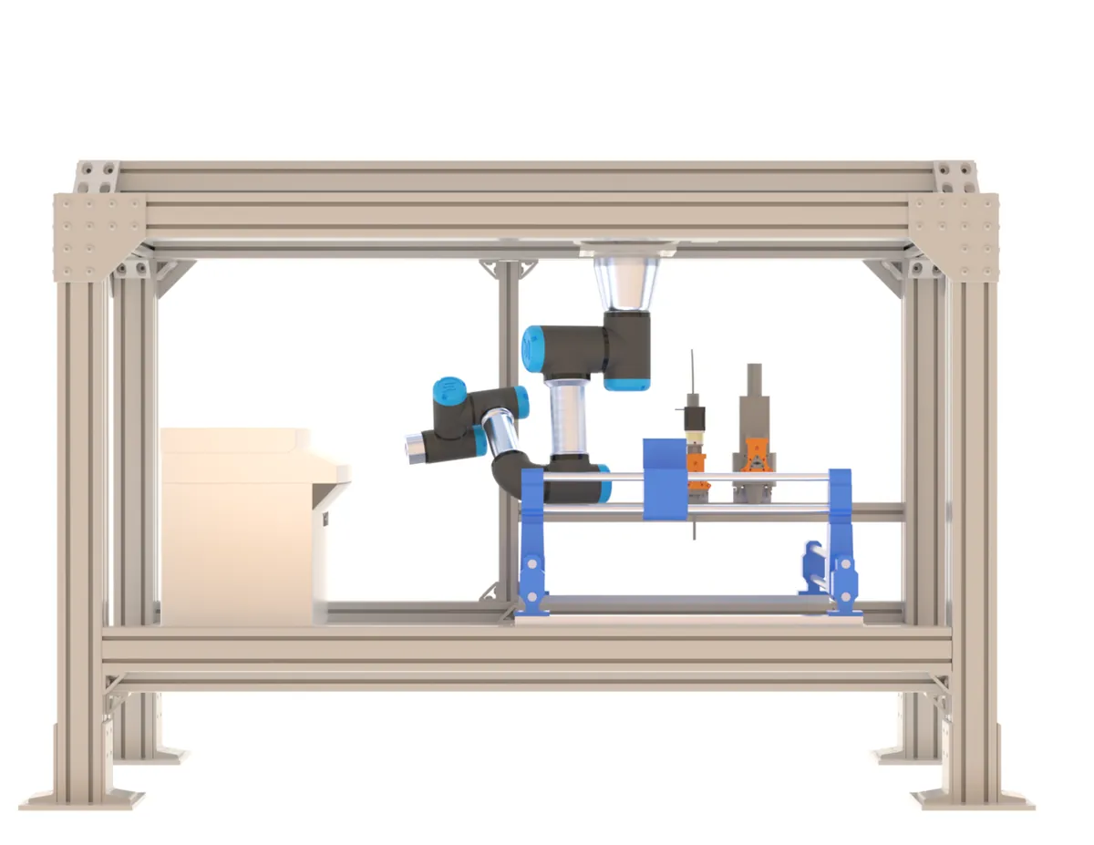
assets/img/formulator/cell-side.webp
