mahdi-rstgr/formulation-sdl-atlas/assets/img/formulator/cell-studio.webp

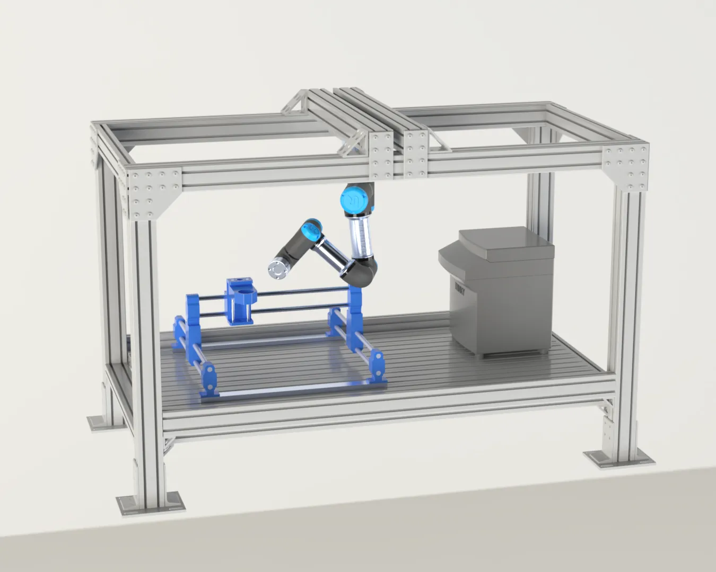
assets/img/formulator/cell-studio.webp
