mahdi-rstgr/formulation-sdl-atlas/assets/img/formulator/detail-arm-gantry.webp

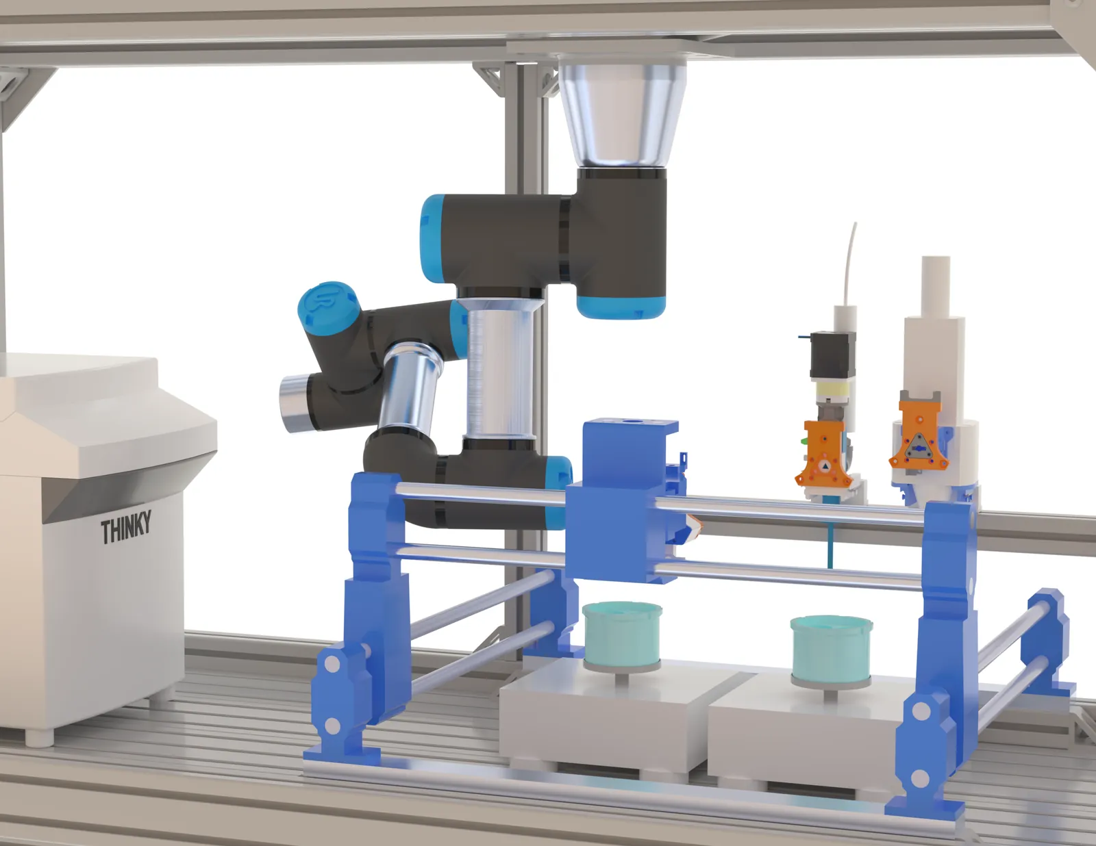
assets/img/formulator/detail-arm-gantry.webp
