mahdi-rstgr/formulation-sdl-atlas/assets/img/formulator/detail-tools.webp

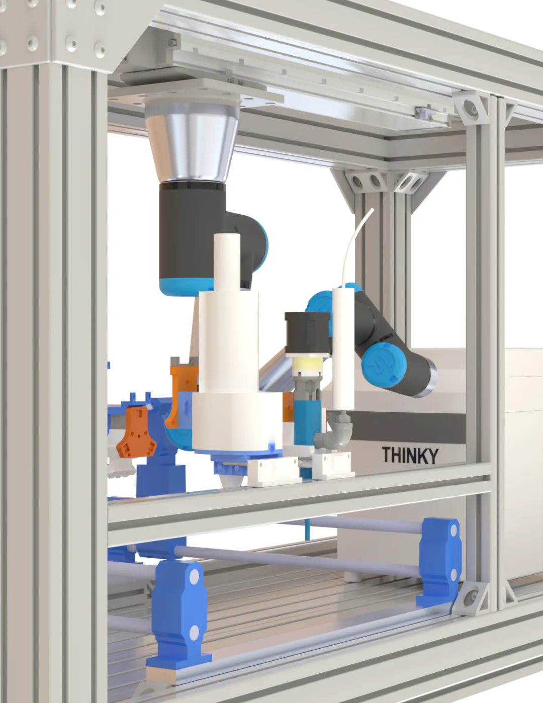
assets/img/formulator/detail-tools.webp
