mahdi-rstgr/formulation-sdl-atlas/assets/img/hero-product-loop.webp

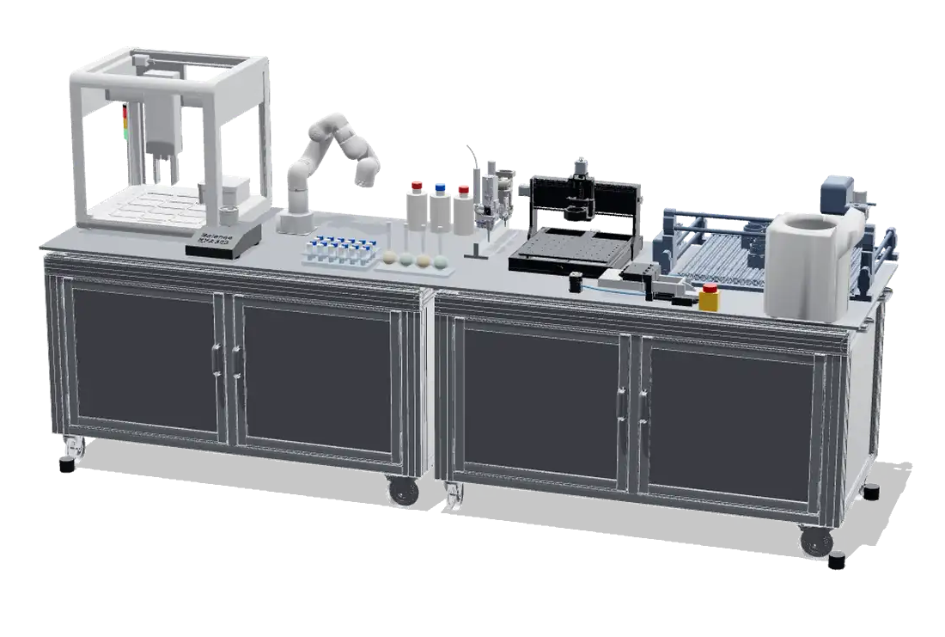
assets/img/hero-product-loop.webp
