mahdi-rstgr/formulation-sdl-atlas/assets/img/hero-sdl.webp

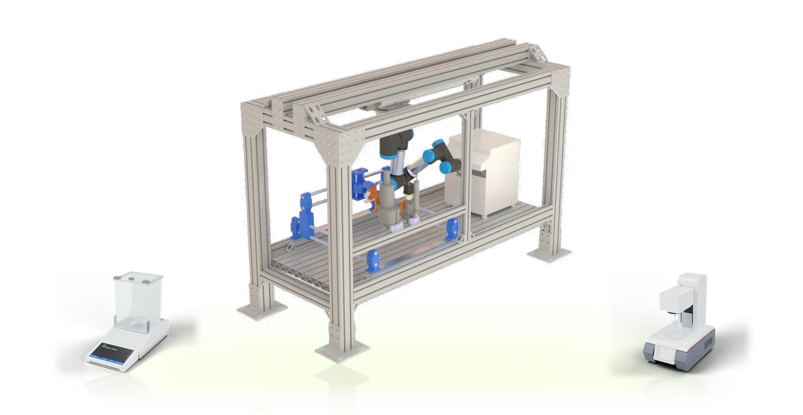
assets/img/hero-sdl.webp
