mahdi-rstgr/formulation-sdl-atlas/assets/img/lab-orbit-poster.webp

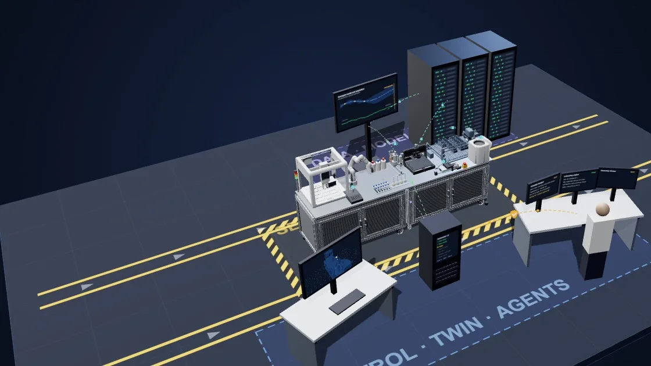
assets/img/lab-orbit-poster.webp
