mahdi-rstgr/formulation-sdl-atlas/assets/img/platform-hero.webp

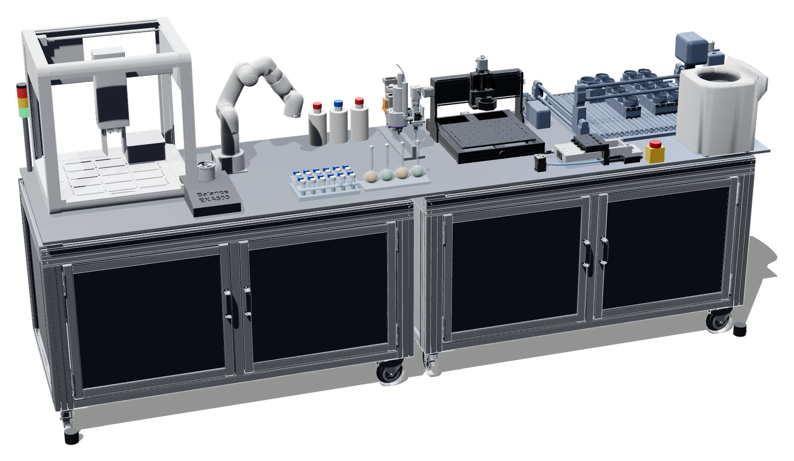
assets/img/platform-hero.webp
