mahdi-rstgr/formulation-sdl-atlas/assets/img/templates/biocompat.webp

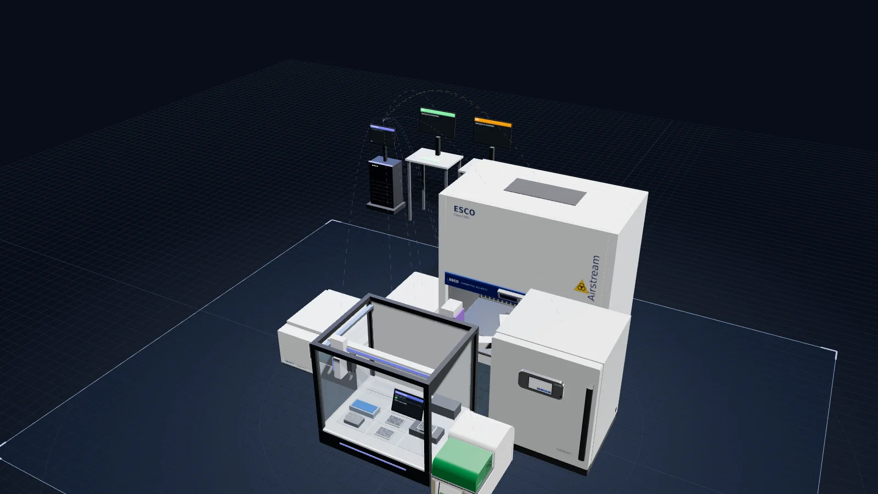
assets/img/templates/biocompat.webp
