mahdi-rstgr/formulation-sdl-atlas/assets/img/templates/drug.webp

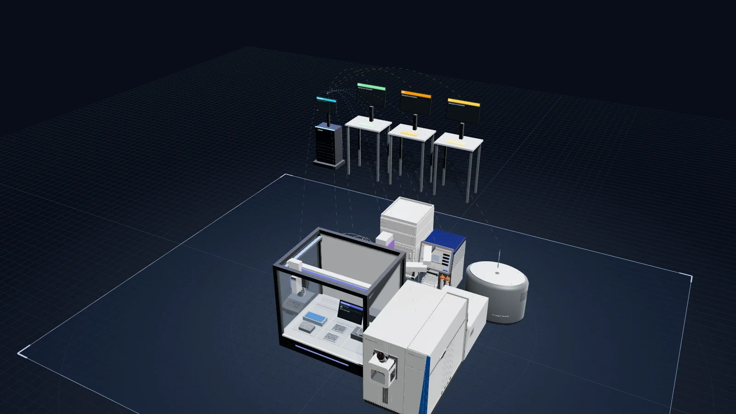
assets/img/templates/drug.webp
