mahdi-rstgr/formulation-sdl-atlas/assets/img/templates/formulation.webp

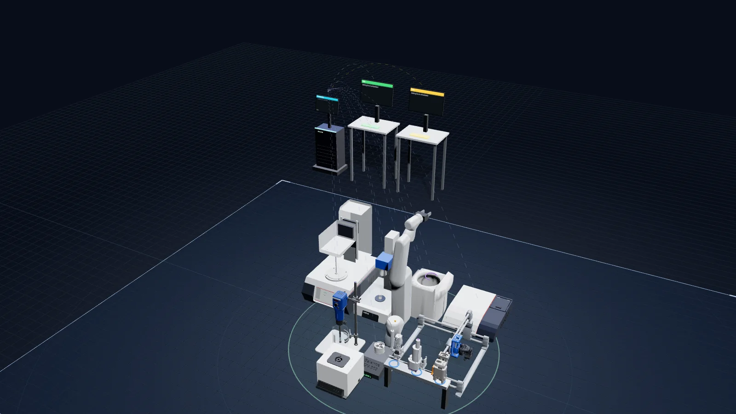
assets/img/templates/formulation.webp
