mahdi-rstgr/formulation-sdl-atlas/assets/img/templates/liquid.webp

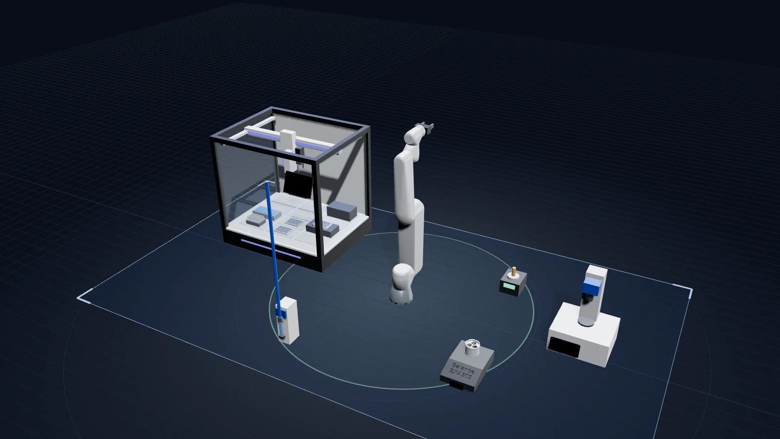
assets/img/templates/liquid.webp
