mahdi-rstgr/formulation-sdl-atlas/assets/img/templates/loop.webp

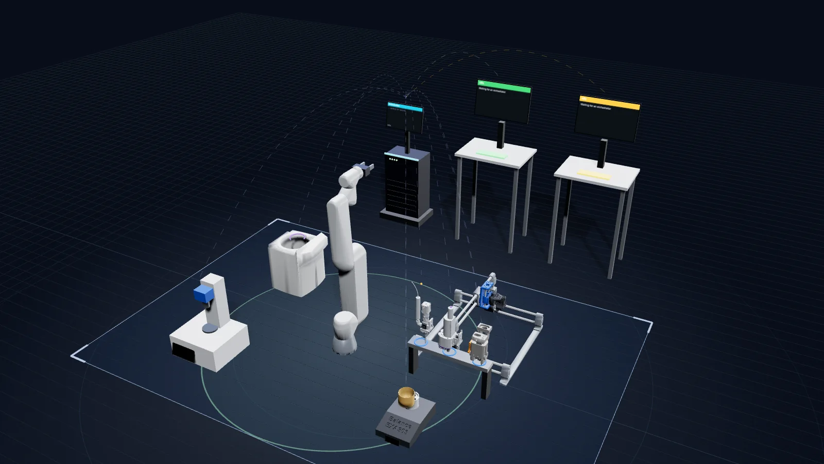
assets/img/templates/loop.webp
