mahdi-rstgr/formulation-sdl-atlas/assets/img/templates/mounted.webp

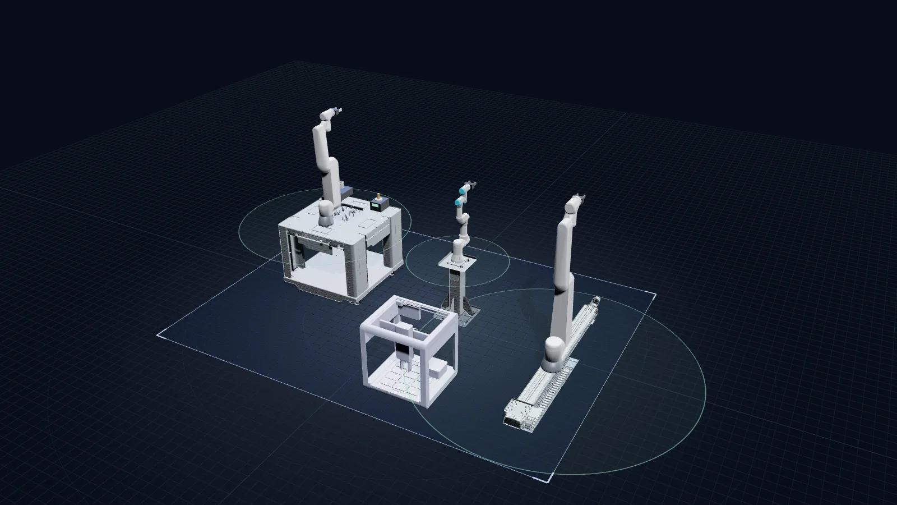
assets/img/templates/mounted.webp
