mahdi-rstgr/formulation-sdl-atlas/assets/img/templates/platforms.webp

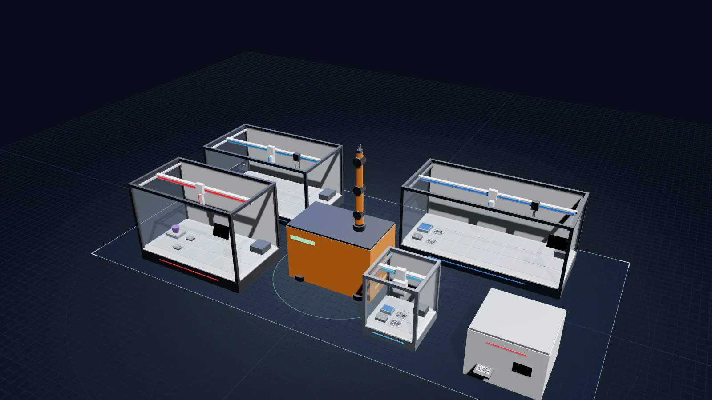
assets/img/templates/platforms.webp
