mahdi-rstgr/formulation-sdl-atlas/assets/img/templates/powder.webp

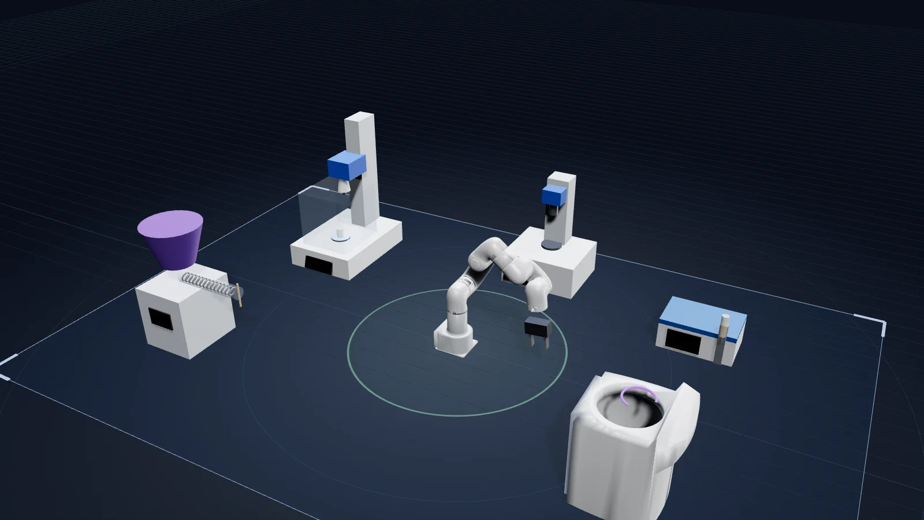
assets/img/templates/powder.webp
