mahdi-rstgr/formulation-sdl-atlas/assets/img/templates/sfl.webp

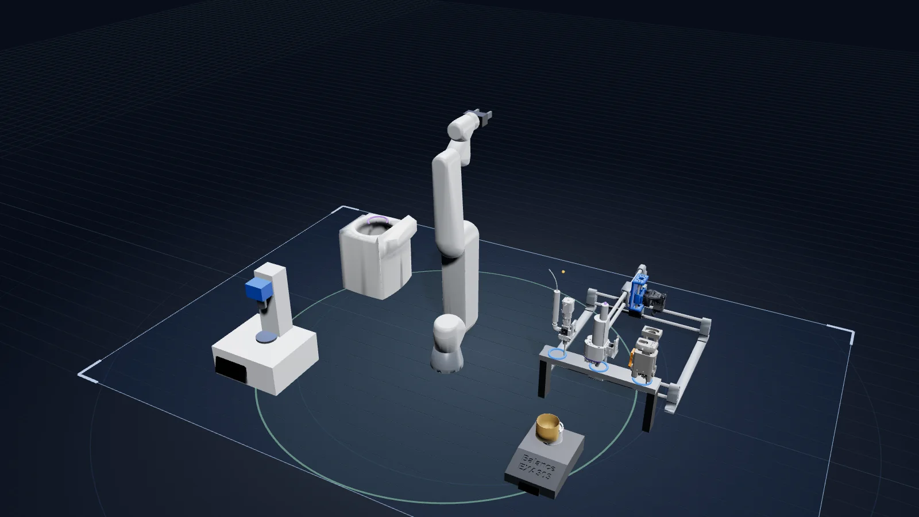
assets/img/templates/sfl.webp
