mahdi-rstgr/formulation-sdl-atlas/figures/figure_01.jpg

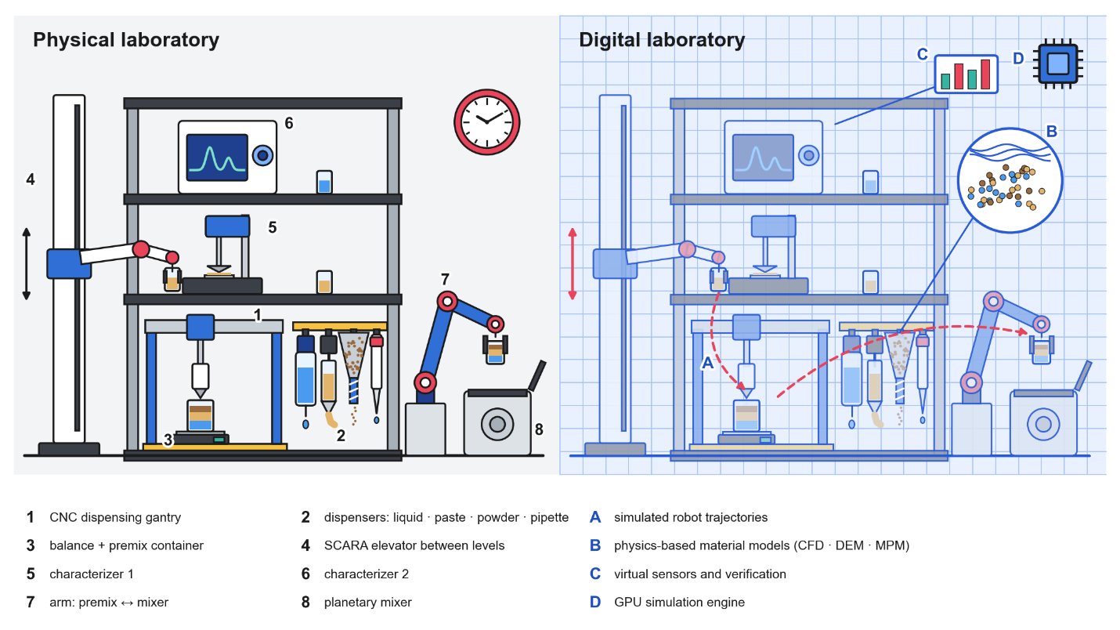
figures/figure_01.jpg
