mahdi-rstgr/formulation-sdl-atlas/figures/figure_06.jpg

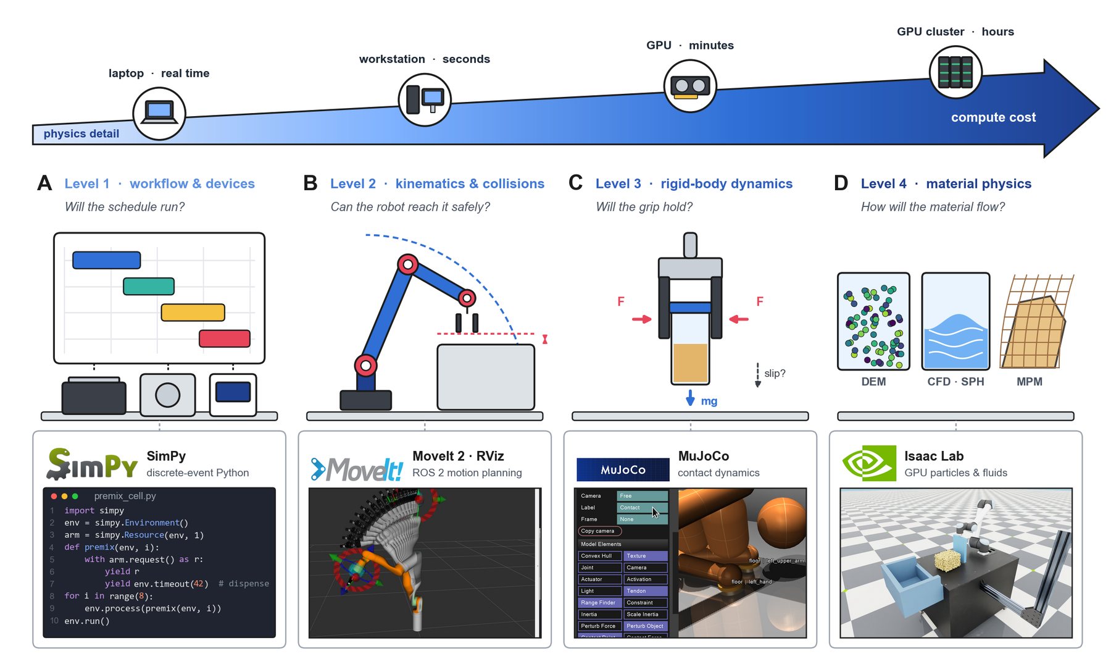
figures/figure_06.jpg
