mahdi-rstgr/formulation-sdl-atlas/figures/figure_09.jpg

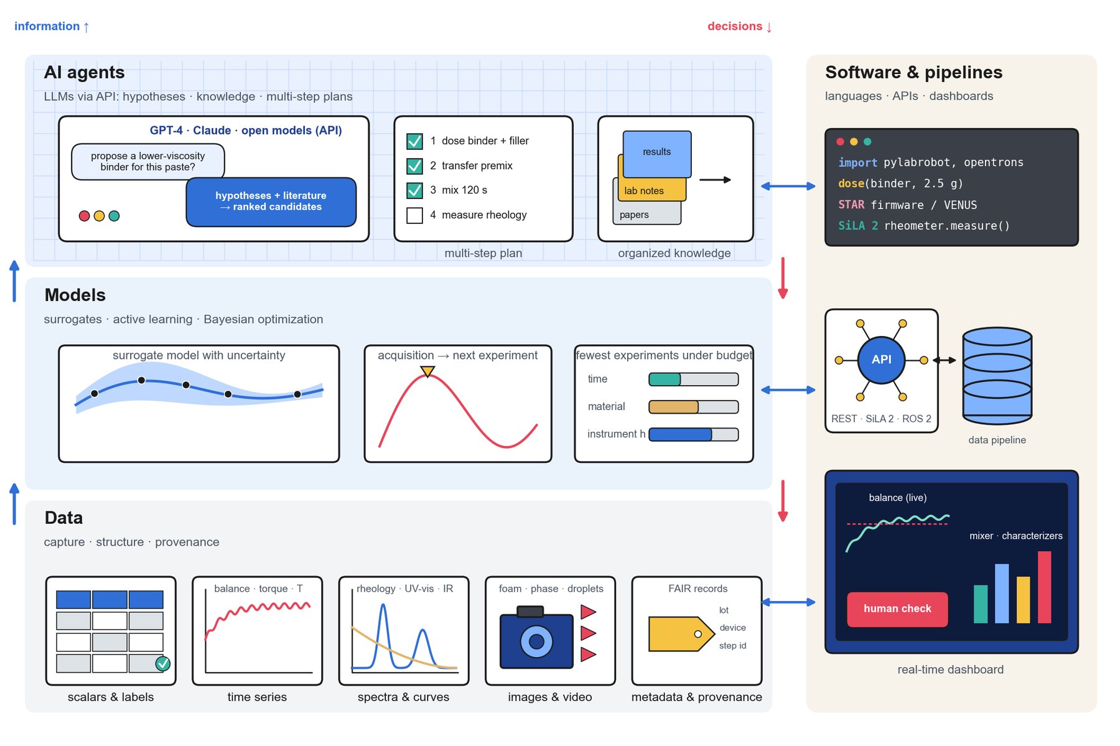
figures/figure_09.jpg
