mahdi-rstgr/formulation-sdl-atlas/figures/graphical_abstract.jpg

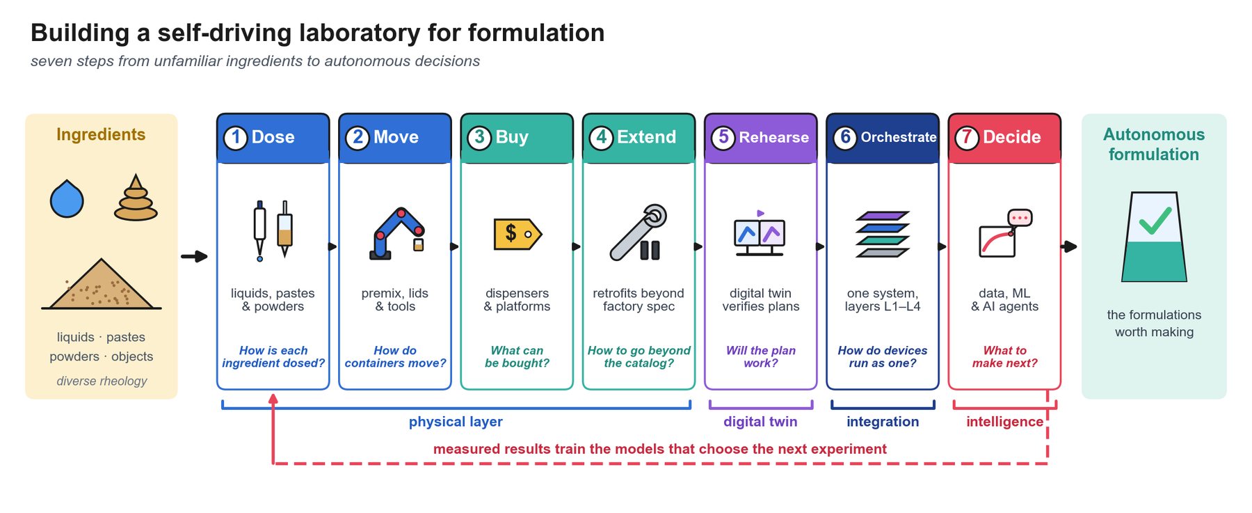
figures/graphical_abstract.jpg
