mahdi-rstgr/formulation-sdl-atlas/lab-simulator/thumbs/ac-atlas.png

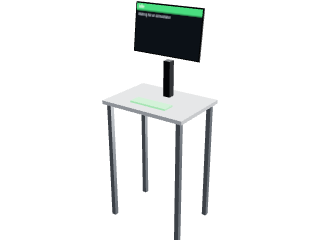
lab-simulator/thumbs/ac-atlas.png
