mahdi-rstgr/formulation-sdl-atlas/lab-simulator/thumbs/alabos.png

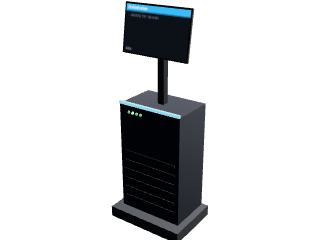
lab-simulator/thumbs/alabos.png
