mahdi-rstgr/formulation-sdl-atlas/lab-simulator/thumbs/biomek.png

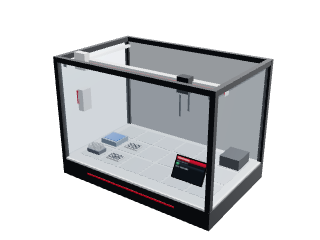
lab-simulator/thumbs/biomek.png
