mahdi-rstgr/formulation-sdl-atlas/lab-simulator/thumbs/eppendorf-xplorer.png

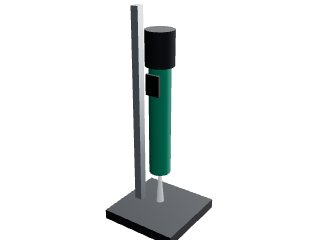
lab-simulator/thumbs/eppendorf-xplorer.png
