mahdi-rstgr/formulation-sdl-atlas/lab-simulator/thumbs/hamilton-psd4.png

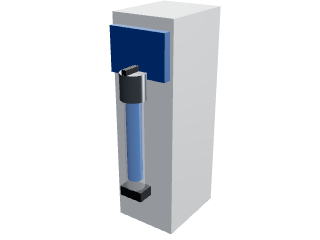
lab-simulator/thumbs/hamilton-psd4.png
