mahdi-rstgr/formulation-sdl-atlas/lab-simulator/thumbs/lab-formulator.png

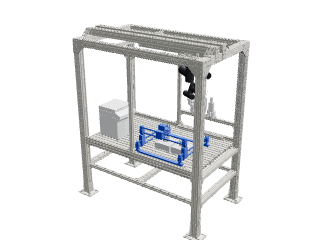
lab-simulator/thumbs/lab-formulator.png
