mahdi-rstgr/formulation-sdl-atlas/lab-simulator/thumbs/mcm-5204n11.png

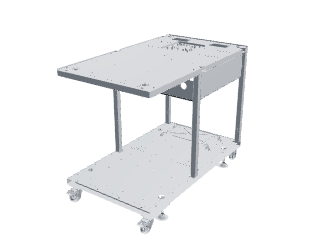
lab-simulator/thumbs/mcm-5204n11.png
