mahdi-rstgr/formulation-sdl-atlas/lab-simulator/thumbs/mcm-6333n117.png

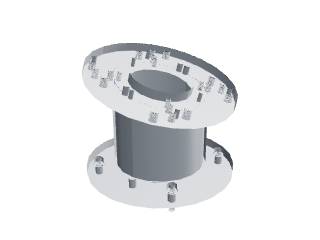
lab-simulator/thumbs/mcm-6333n117.png
