mahdi-rstgr/formulation-sdl-atlas/lab-simulator/thumbs/mcm-9198n23.png

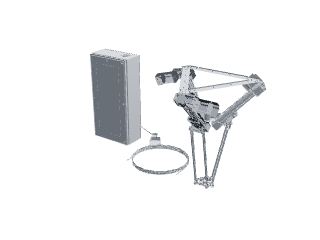
lab-simulator/thumbs/mcm-9198n23.png
