mahdi-rstgr/formulation-sdl-atlas/lab-simulator/thumbs/mcm-9351n11.png

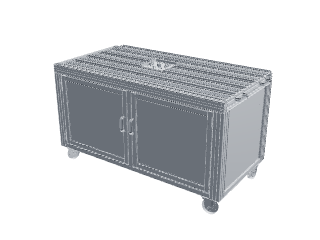
lab-simulator/thumbs/mcm-9351n11.png
