mahdi-rstgr/formulation-sdl-atlas/lab-simulator/thumbs/mt12.png

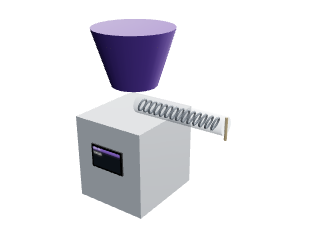
lab-simulator/thumbs/mt12.png
