mahdi-rstgr/formulation-sdl-atlas/lab-simulator/thumbs/peristaltic-pump.png

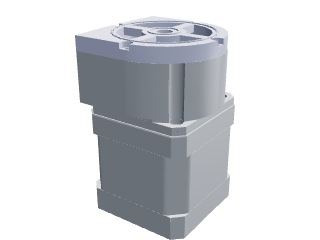
lab-simulator/thumbs/peristaltic-pump.png
