mahdi-rstgr/formulation-sdl-atlas/lab-simulator/thumbs/ur3e.png

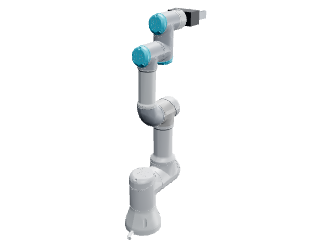
lab-simulator/thumbs/ur3e.png
