mahdi-rstgr/formulation-sdl-atlas/new-design/thumbs/chemspeed.png

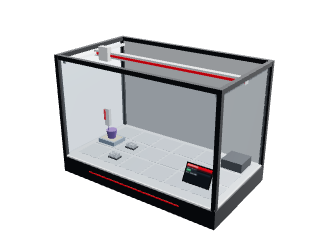
new-design/thumbs/chemspeed.png
