mahdi-rstgr/formulation-sdl-atlas/new-design/thumbs/cnc3030.png

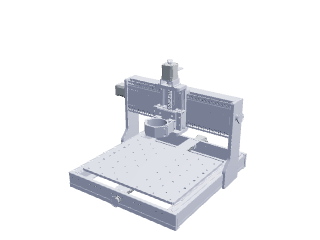
new-design/thumbs/cnc3030.png
