mahdi-rstgr/formulation-sdl-atlas/new-design/thumbs/epmotion.png

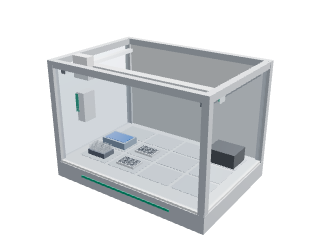
new-design/thumbs/epmotion.png
