mahdi-rstgr/formulation-sdl-atlas/new-design/thumbs/lab-cnc-viscometer.png

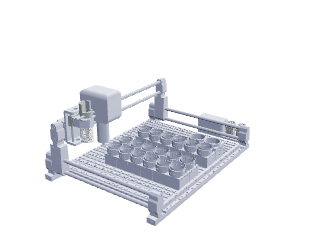
new-design/thumbs/lab-cnc-viscometer.png
