mahdi-rstgr/formulation-sdl-atlas/new-design/thumbs/mcm-3813n14.png

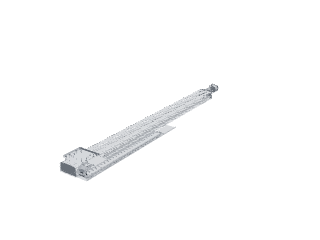
new-design/thumbs/mcm-3813n14.png
