mahdi-rstgr/formulation-sdl-atlas/new-design/thumbs/mcm-5206n15.png

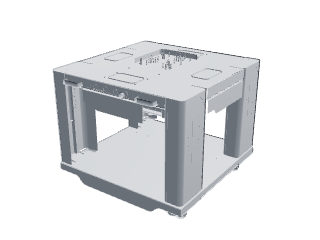
new-design/thumbs/mcm-5206n15.png
