mahdi-rstgr/formulation-sdl-atlas/new-design/thumbs/mcm-6333n16.png

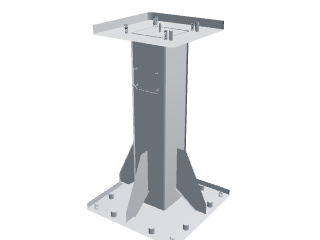
new-design/thumbs/mcm-6333n16.png
