mahdi-rstgr/formulation-sdl-atlas/new-design/thumbs/mcm-9198n17.png

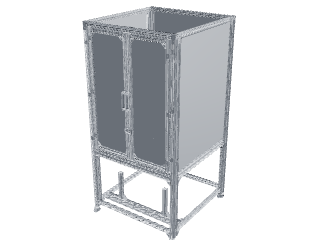
new-design/thumbs/mcm-9198n17.png
