mahdi-rstgr/formulation-sdl-atlas/new-design/thumbs/ot2.png

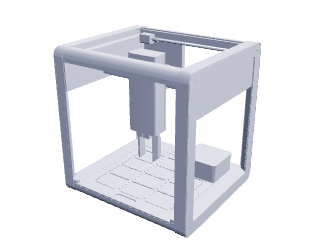
new-design/thumbs/ot2.png
