mahdi-rstgr/formulation-sdl-atlas/new-design/thumbs/qdos20.png

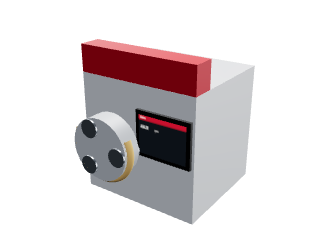
new-design/thumbs/qdos20.png
