mahdi-rstgr/formulation-sdl-atlas/new-design/thumbs/reciprocating-pump.png

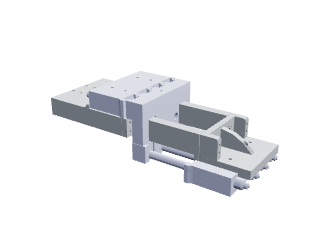
new-design/thumbs/reciprocating-pump.png
