mahdi-rstgr/formulation-sdl-atlas/new-design/thumbs/sensirion-slf3s.png

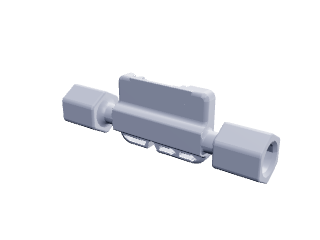
new-design/thumbs/sensirion-slf3s.png
