mahdi-rstgr/formulation-sdl-atlas/new-design/thumbs/ur3e.png

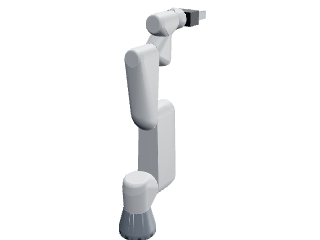
new-design/thumbs/ur3e.png
