mahdi-rstgr/formulation-sdl-atlas/new-design/thumbs/vortex.png

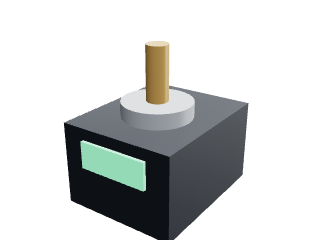
new-design/thumbs/vortex.png
