mahdi-rstgr/formulation-sdl-atlas/wiki/assets/figure_02.jpg

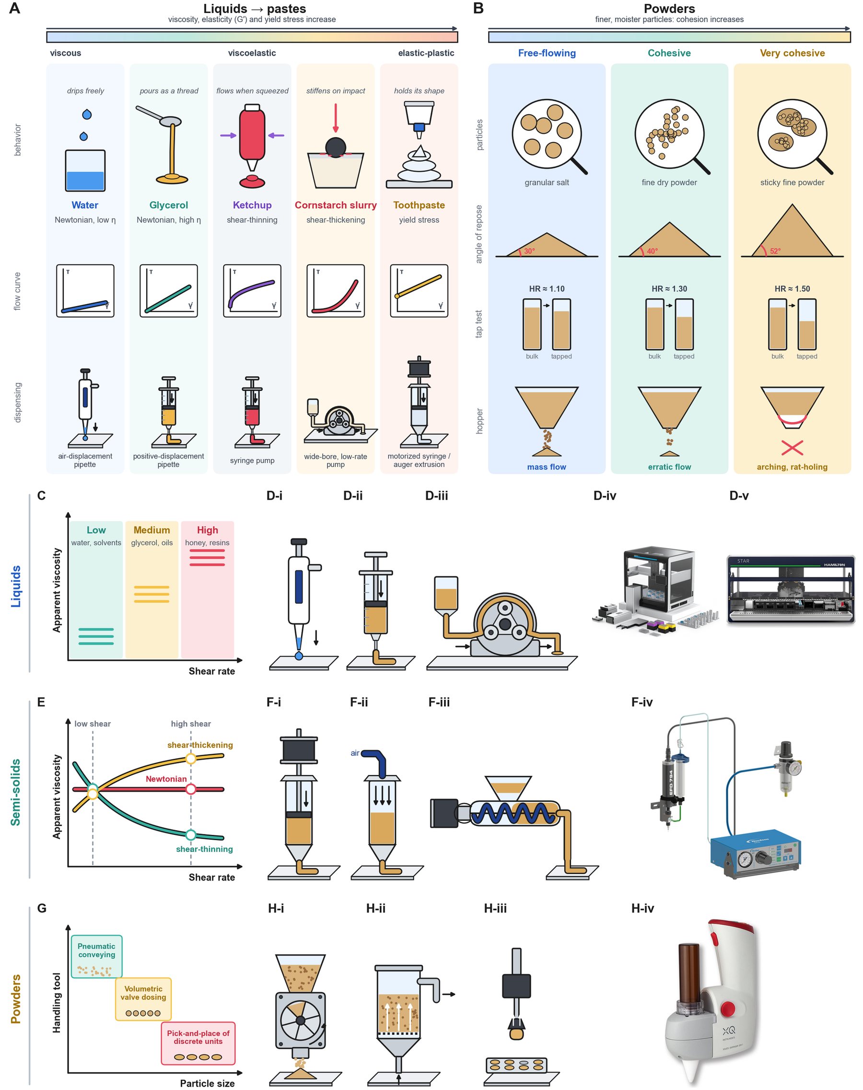
wiki/assets/figure_02.jpg
