mahdi-rstgr/formulation-sdl-atlas/wiki/assets/figure_03.jpg

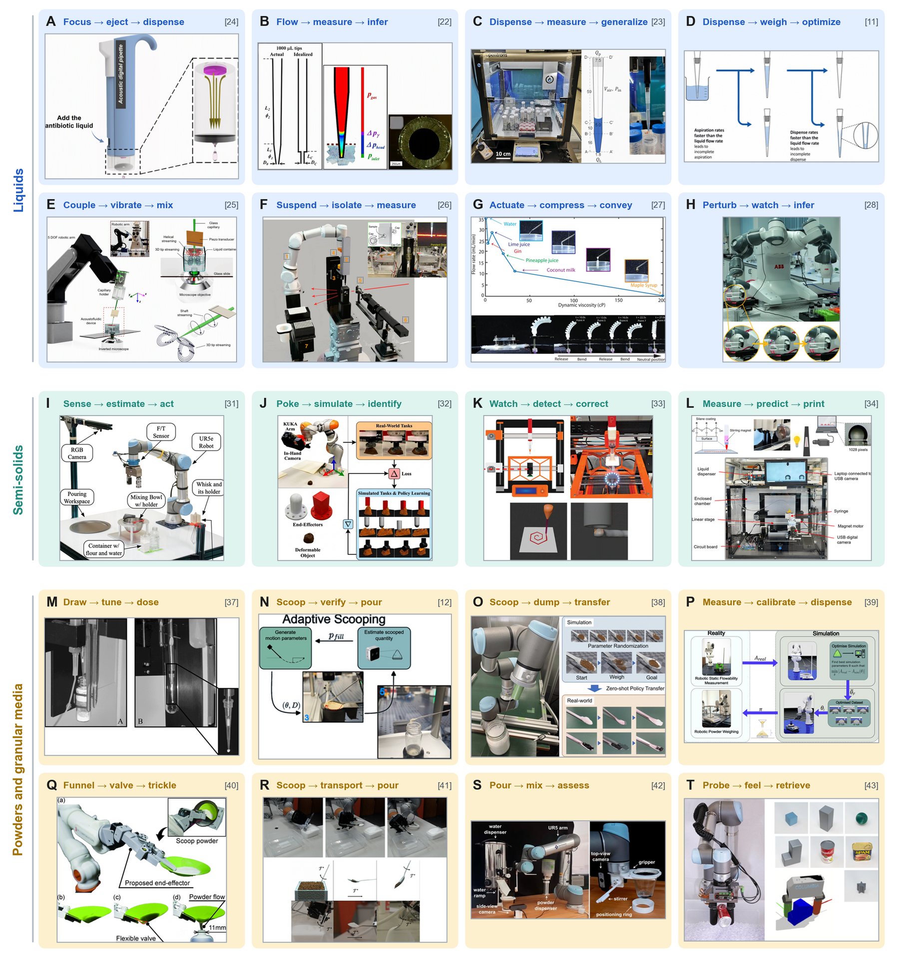
wiki/assets/figure_03.jpg
