mahdi-rstgr/formulation-sdl-atlas/wiki/assets/figure_04.jpg

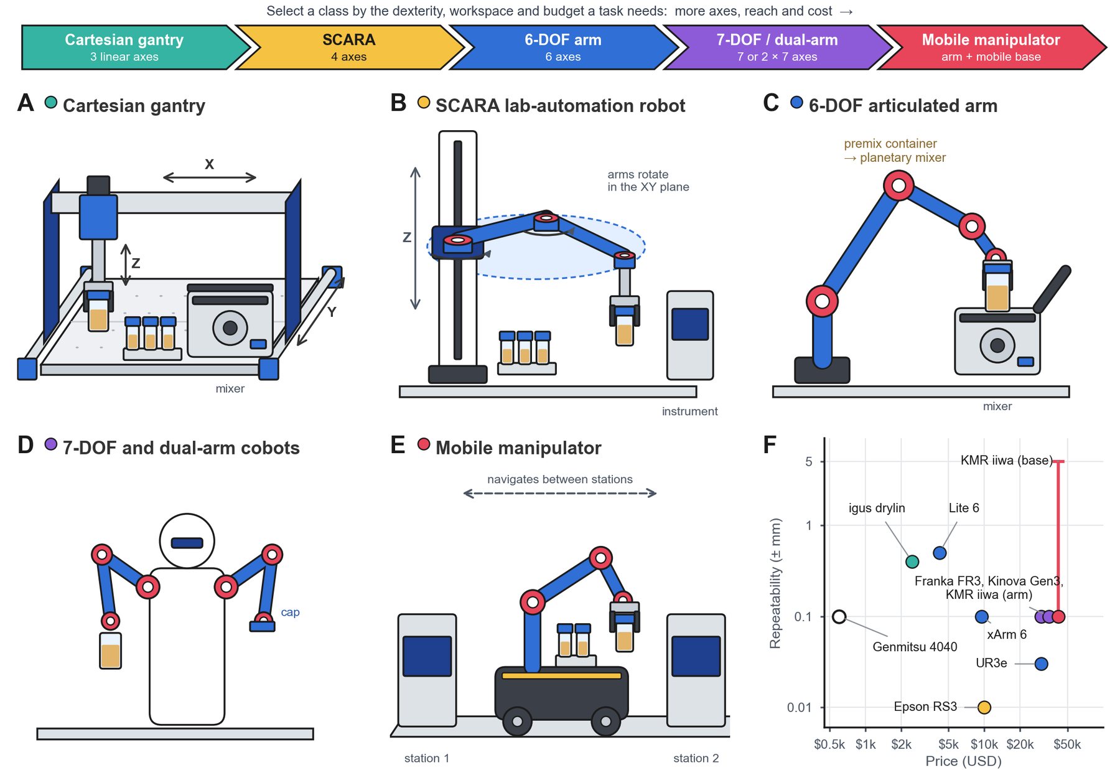
wiki/assets/figure_04.jpg
