mahdi-rstgr/formulation-sdl-atlas/wiki/assets/figure_07.jpg

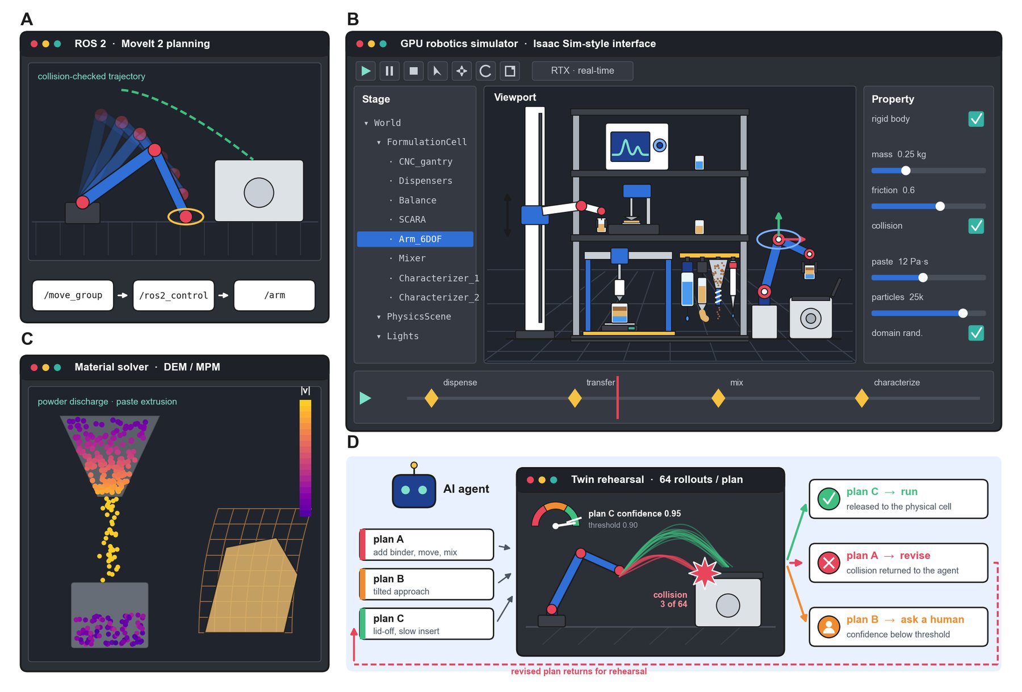
wiki/assets/figure_07.jpg
