mahdi-rstgr/formulation-sdl-atlas/wiki/assets/figure_08.jpg

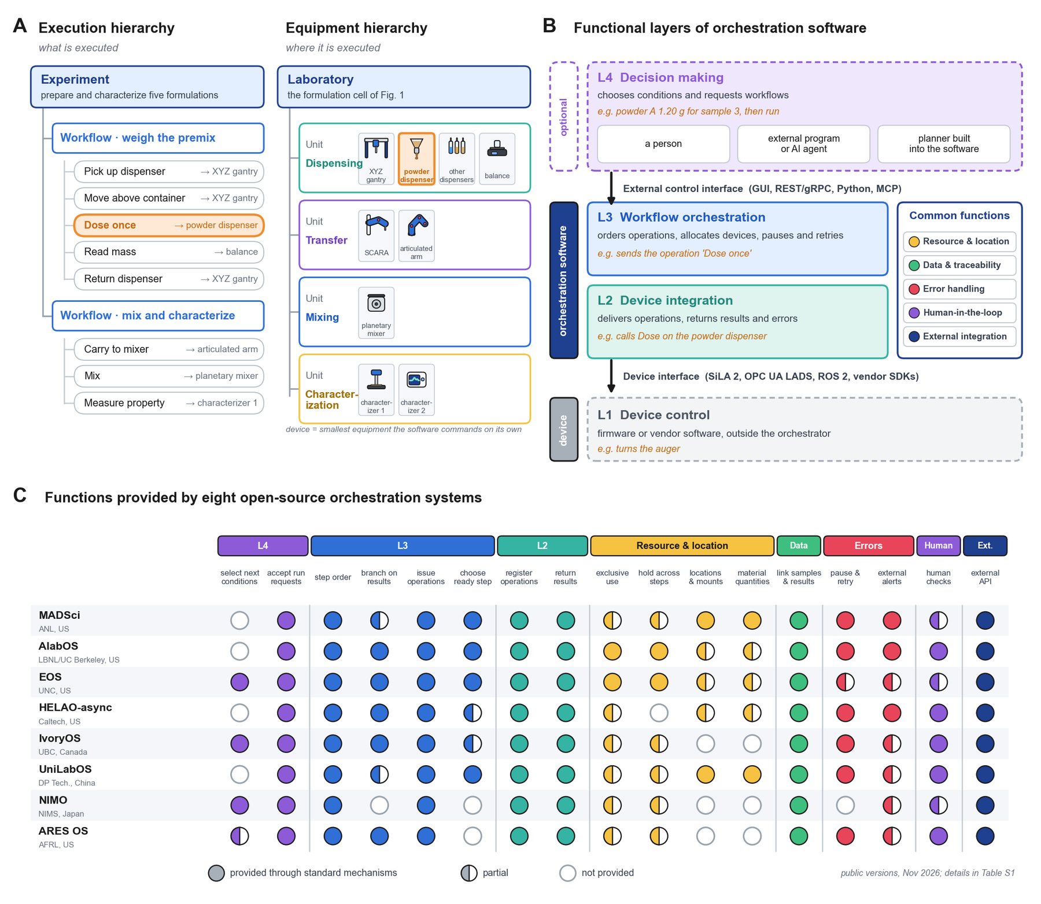
wiki/assets/figure_08.jpg
