mahdi-rstgr/formulation-sdl-atlas/new/CNC_Viscometer.STEP

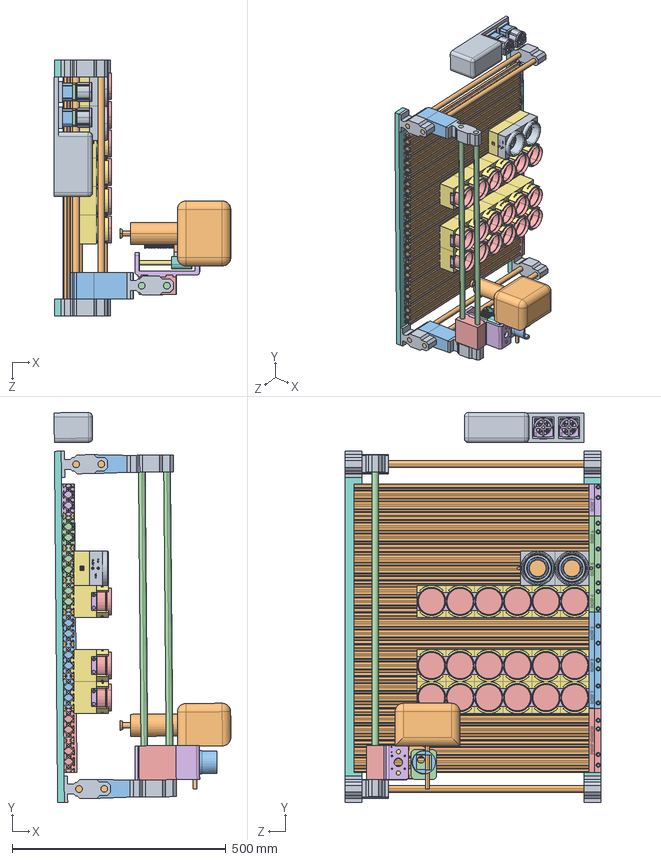
[picture p79: CAD file, 2026-11-09]
new/CNC_Viscometer.STEP
414.0 x 912.7 x 599.0 mm
4633N91_T-Slotted Framing Rail_4633N91 x 9
rail_lock_V3
rail_lock2_V3
rail_lock3_V3
rail_lock4_V3
Container without Viscometer - V2 x 18
cnc_x_axis x 2
cnc_base_support x 6
cnc_shaft x 4
cnc_axis_support x 2
cnc_shaft_y x 2
cnc_axis_support_y
cnc_arm
arm_cylinder x 2
z_axis
viscometer_holder
sup
container x 18
heater x 3
Wahsing Holder Single x 2
Hub3 x 2
Wahsing Cup - v3 x 2
Spinner_new_v3 x 2
spinner_ring_2 x 2
底部塑料盖子_默认 x 2
铁芯_默认 x 2
电耦片_默认 x 2
电刷_默认 x 2
电偶绝缘块_默认 x 2
磁铁_默认 x 2
端子_默认 x 4
马达外壳_默认 x 2
轴_默认 x 2
绝缘垫片_默认 x 2
减速机支架_默认 x 2
十字沉头螺丝_默认 x 8
Engrenagem reta28-D_默认 x 2
Engrenagem reta22-11_默认 x 4
WHEEL x 2
WORM x 2
bearing cup x 2
magnet x 8
Mulit-Roller-Gen2.1-C2 x 2
Multi-HubBottom-gen2.1-C2 x 2
Multi-Hub-gen2.1-C2 x 2
Multi-Lid-Gen2.1-C2 x 2
Multi-SunGear-Gen2.1-C2 x 2
Multi-Support - Gen2.1-C2 x 2
Nima 17 40x42x5mm - gen2.1-C2 x 2
liquid_handler_holder
viscometer - 2
