mahdi-rstgr/formulation-sdl-atlas/new/reciprocating_pump.STEP

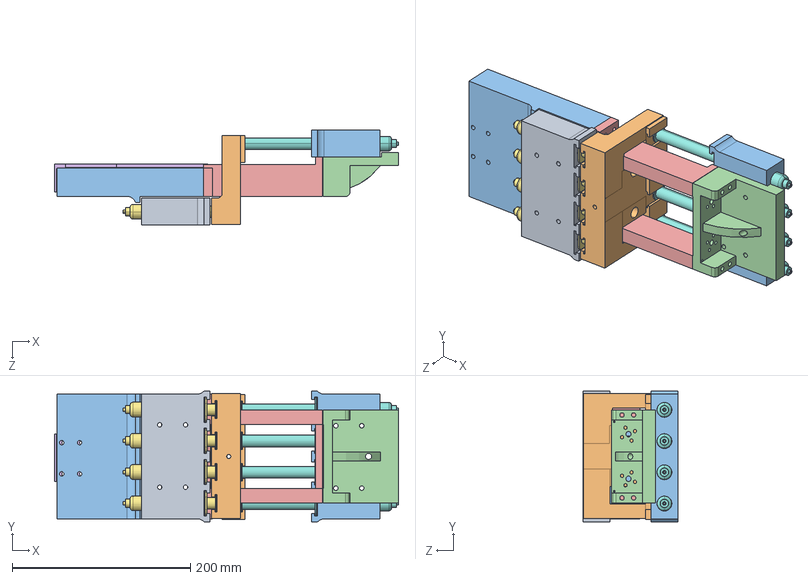
[picture p80: CAD file, 2026-11-09]
new/reciprocating_pump.STEP
385.6 x 146.7 x 106.5 mm
L16_100MM_BODY_A
L16_100MM_LIFT_A
Syringe_housing_V2
Act_housing_V2
Pump_v3-0
Pump_v3-1
Pump_v3-2
Pump_v3-3
Pump_v3-4
Pump_v3-5
Pump_v3-6
Pump_v3-7
Pump_v3-8
Pump_v3-9
Pump_v3-10
