mahdi-rstgr/formulation-sdl-atlas/new/peristaltic pump.STEP

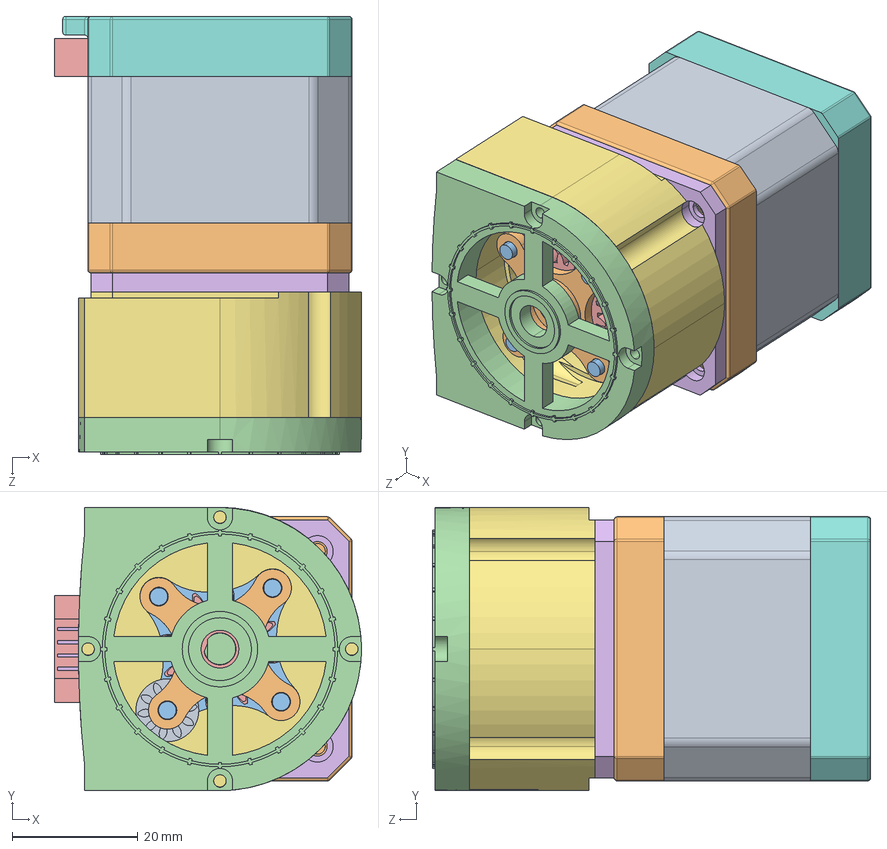
[picture p82: CAD file, 2026-11-09]
new/peristaltic pump.STEP
48.8 x 45.1 x 69.7 mm
UNIVIVER2Mulit-Roller-Gen2.1-C2
UNIVIVER2Multi-HubBottom-gen2.1-C2
UNIVIVER2Multi-Hub-gen2.1-C2
UNIVIVER2Multi-Lid-Gen2.1-C2
UNIVIVER2Multi-SunGear-Gen2.1-C2
UNIVIVER2Multi-Support - Gen2.1-C2
UNIVIVER2Nima 17 40x42x5mm - gen2.1-C2
