mahdi-rstgr/formulation-sdl-atlas/(list of files, cad)

Other CAD files:
new/inflow_visco.STEP
new/genmitsu gantry 3030.STEP
