mahdi-rstgr/formulation-sdl-atlas/builder/thumbs/balance.png

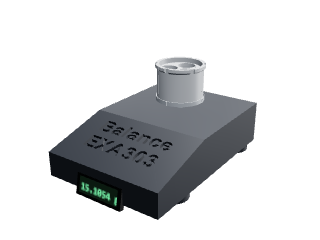
builder/thumbs/balance.png
