mahdi-rstgr/formulation-sdl-atlas/builder/thumbs/bravo.png

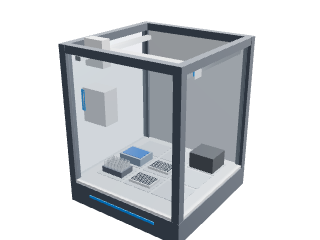
builder/thumbs/bravo.png
