mahdi-rstgr/formulation-sdl-atlas/builder/thumbs/cnc4040.png

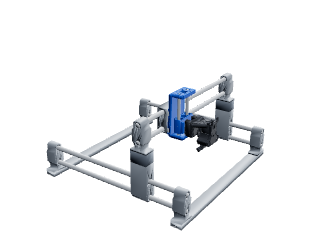
builder/thumbs/cnc4040.png
