mahdi-rstgr/formulation-sdl-atlas/builder/thumbs/cup.png

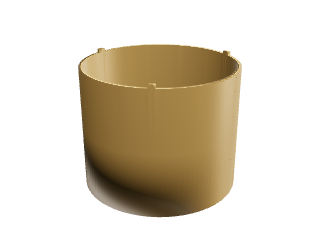
builder/thumbs/cup.png
