mahdi-rstgr/formulation-sdl-atlas/builder/thumbs/drylin.png

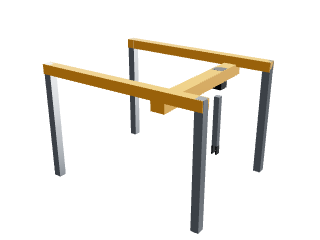
builder/thumbs/drylin.png
