mahdi-rstgr/formulation-sdl-atlas/builder/thumbs/echo.png

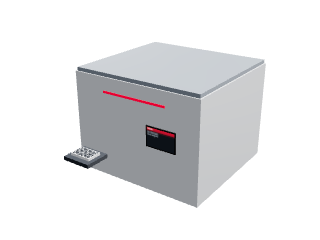
builder/thumbs/echo.png
