mahdi-rstgr/formulation-sdl-atlas/builder/thumbs/flex.png

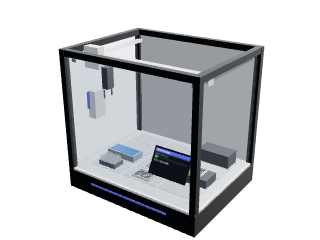
builder/thumbs/flex.png
