mahdi-rstgr/formulation-sdl-atlas/builder/thumbs/fluent.png

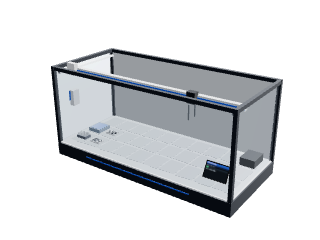
builder/thumbs/fluent.png
