mahdi-rstgr/formulation-sdl-atlas/builder/thumbs/fr3.png

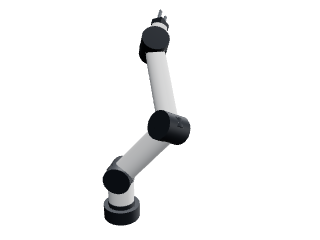
builder/thumbs/fr3.png
