mahdi-rstgr/formulation-sdl-atlas/builder/thumbs/jubilee.png

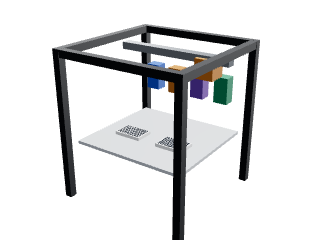
builder/thumbs/jubilee.png
