mahdi-rstgr/formulation-sdl-atlas/builder/thumbs/kmr.png

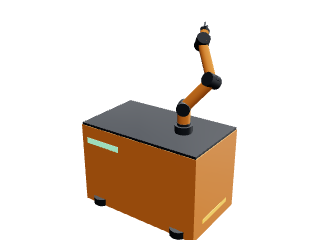
builder/thumbs/kmr.png
