mahdi-rstgr/formulation-sdl-atlas/builder/thumbs/lite6.png

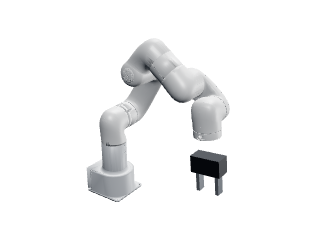
builder/thumbs/lite6.png
