mahdi-rstgr/formulation-sdl-atlas/builder/thumbs/pf400.png

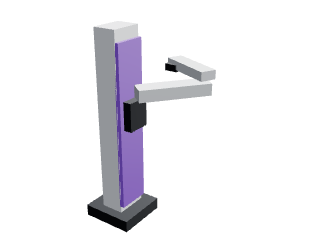
builder/thumbs/pf400.png
