mahdi-rstgr/formulation-sdl-atlas/builder/thumbs/quantos.png

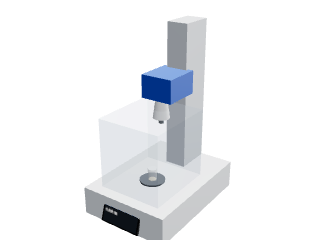
builder/thumbs/quantos.png
