mahdi-rstgr/formulation-sdl-atlas/builder/thumbs/rs3.png

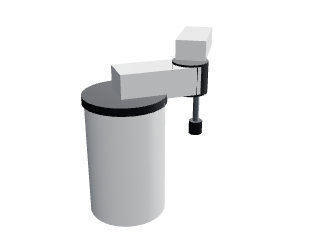
builder/thumbs/rs3.png
