mahdi-rstgr/formulation-sdl-atlas/builder/thumbs/star.png

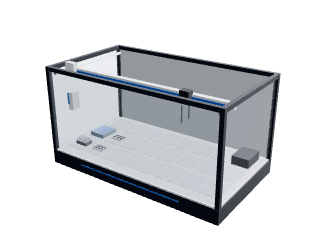
builder/thumbs/star.png
