mahdi-rstgr/formulation-sdl-atlas/builder/thumbs/thinky.png

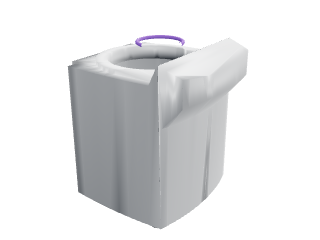
builder/thumbs/thinky.png
