mahdi-rstgr/formulation-sdl-atlas/builder/thumbs/ultimus.png

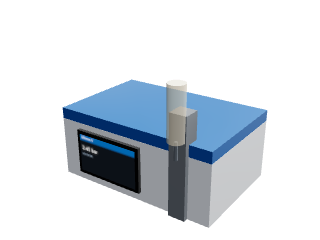
builder/thumbs/ultimus.png
