mahdi-rstgr/formulation-sdl-atlas/builder/thumbs/ur5e.png

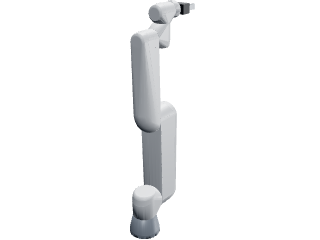
builder/thumbs/ur5e.png
