mahdi-rstgr/formulation-sdl-atlas/builder/thumbs/ur16e.png

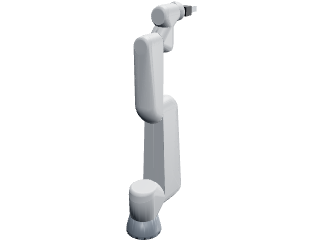
builder/thumbs/ur16e.png
