mahdi-rstgr/formulation-sdl-atlas/builder/thumbs/vf1.png

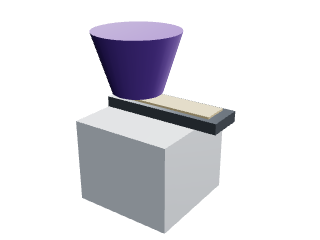
builder/thumbs/vf1.png
