mahdi-rstgr/formulation-sdl-atlas/builder/thumbs/xarm6.png

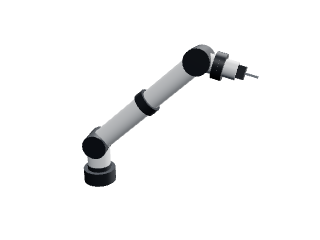
builder/thumbs/xarm6.png
