mahdi-rstgr/formulation-sdl-atlas/lab-simulator/thumbs/lab-formulator-pen-assembly.png

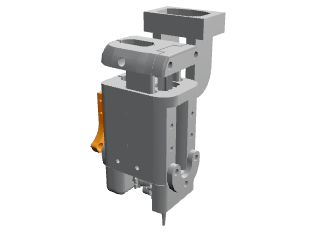
lab-simulator/thumbs/lab-formulator-pen-assembly.png
