mahdi-rstgr/formulation-sdl-atlas/lab-simulator/thumbs/characterizer.png

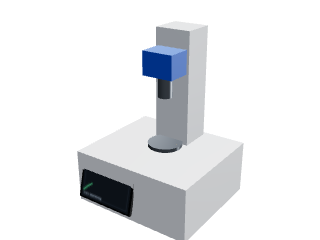
lab-simulator/thumbs/characterizer.png
