mahdi-rstgr/formulation-sdl-atlas/(commit log)

2026-11-07 Formulation SDL Atlas: interactive site, V3 wiki, review data and digital twin
    - index.html + assets/: seven-step scroll story with a live three.js twin of the
    Self-Formulating Lab cell, charts and catalogue built from review Tables 1-7,
    the 20 Fig. 3 scenarios, and a preview of the SFL agent's selection step
    - data/: review.json (final V3 manuscript, 8 authors, 178 references) and
    per-arm twin scenes with RRT-Connect transfers planned offline
    - wiki-src/ + wiki/: the material-handling wiki rebuilt from manuscript V3
    - docs/: library agent and SFL agent specs, data guide, roadmap
2026-11-07 Add the Lab Builder; show all figures in a restyled wiki
    - builder/: drag-and-drop 3D workstation with 39 devices in six categories
    (material handlers, CNC gantry with tool dock, the review's five robot
    classes, mixers, stations, integrated platforms), live cart priced from
    review Tables 2-4, overlap/reach/workstation checks, templates, share
    links and CSV parts list
    - data/models/: real meshes (formulation-cell devices, UR e-Series,
    UFACTORY Lite 6, BSD-3) exported by scripts/export_models.py; other
    devices are procedural models at approximate footprints
    - wiki: all ten manuscript figures with full captions, figure gallery and
    lightbox, atlas typography and palette, top tabs,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
2026-11-07 Lab Builder v2: device banner, live animated models, 6-DOF gizmo, cell intelligence
    - banner library under the top bar with rendered thumbnails; full-width stage
    - every device runs while placed: liquid handlers pick tips, aspirate and fill
    plates column by column; CNC axes trace a path; pumps, feeders, Quantos,
    balance and rheometer animate with live screens; articulated UR e-Series
    arms replay planned RRT-Connect transfers; Lite 6 and procedural arms move
    - numbered devices linked to cart rows on hover; tooltips with price
    - move/rotate gizmo plus numeric X/Y/Z/roll/pitch/yaw; dock snapping
    - capability check with one-click fixes, auto-arrange, live metrics
    - shadows, environment lig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
2026-11-08 Add new design for Formulation Lab Builder with initial HTML structure and assets
    - Created index.html for the Lab Builder interface, including header, main application area, and sidebar for cart and cell intelligence.
    - Added various device thumbnails to the thumbs directory for visual representation of devices in the lab.
2026-11-08 Add self-driving layer and solutions pages, including SVG assets
    - Created index.html for the self-driving layer with detailed architecture, orchestration, rehearsal, and decision-making sections.
    - Developed index.html for solutions, showcasing material-based technologies, design templates, and proven loops.
    - Added SVG assets for branding in both wiki and main assets directories.
2026-11-09 Add self-driving laboratory workflow and safety mechanisms
    - Introduced a new JavaScript file `sdl-workflow.js` containing the workflow stages for the self-driving laboratory, detailing physical, digital, and intelligence components along with safety measures.
    - Added multiple STEP files for various components including CNC viscometer, liquid flow software, gantry, inflow viscometer, OT-2, and pumps to the `new` directory.
    - Created a Python script `build_brand.py` to generate brand assets in SVG format, including wordmarks and logos.
    - Added favicon SVG files for the Labu brand in both `wiki-src` and `wiki` directories.
2026-11-10 Add platform rendering and assets for the Assemblab demonstration platform
    - Implemented platform rendering logic in `assets/platform.js` to create a 3D model of the self-driving formulation station.
    - Created `data/platform-hero.json` to define the visual regions and properties of the platform for the homepage.
    - Developed `tools/render-platform.html` for rendering the platform hero and generating hotspot outlines.
    - Added SVG assets for the Assemblab favicon and logo in multiple locations for branding consistency.
2026-11-11 Add script to import ChemLab-Assets instrument library into the assemblab catalogue
    This script fetches data from the ChemLab-Assets public catalogue and generates a JavaScript file containing instrument entries. It handles thumbnail downloads and categorization of instruments while skipping those already present in the catalogue. The generated file includes metadata and licensing information.
